sbiruduganti/IEEE-EOH-Acoustic-Array-Lung-Monitor/circuit-design/README.md

# circuit-design

Hardware design files for the 8-channel acoustic lung monitor ADC board.
