sbiruduganti/IEEE-EOH-Acoustic-Array-Lung-Monitor/adc_board-schematic.pdf

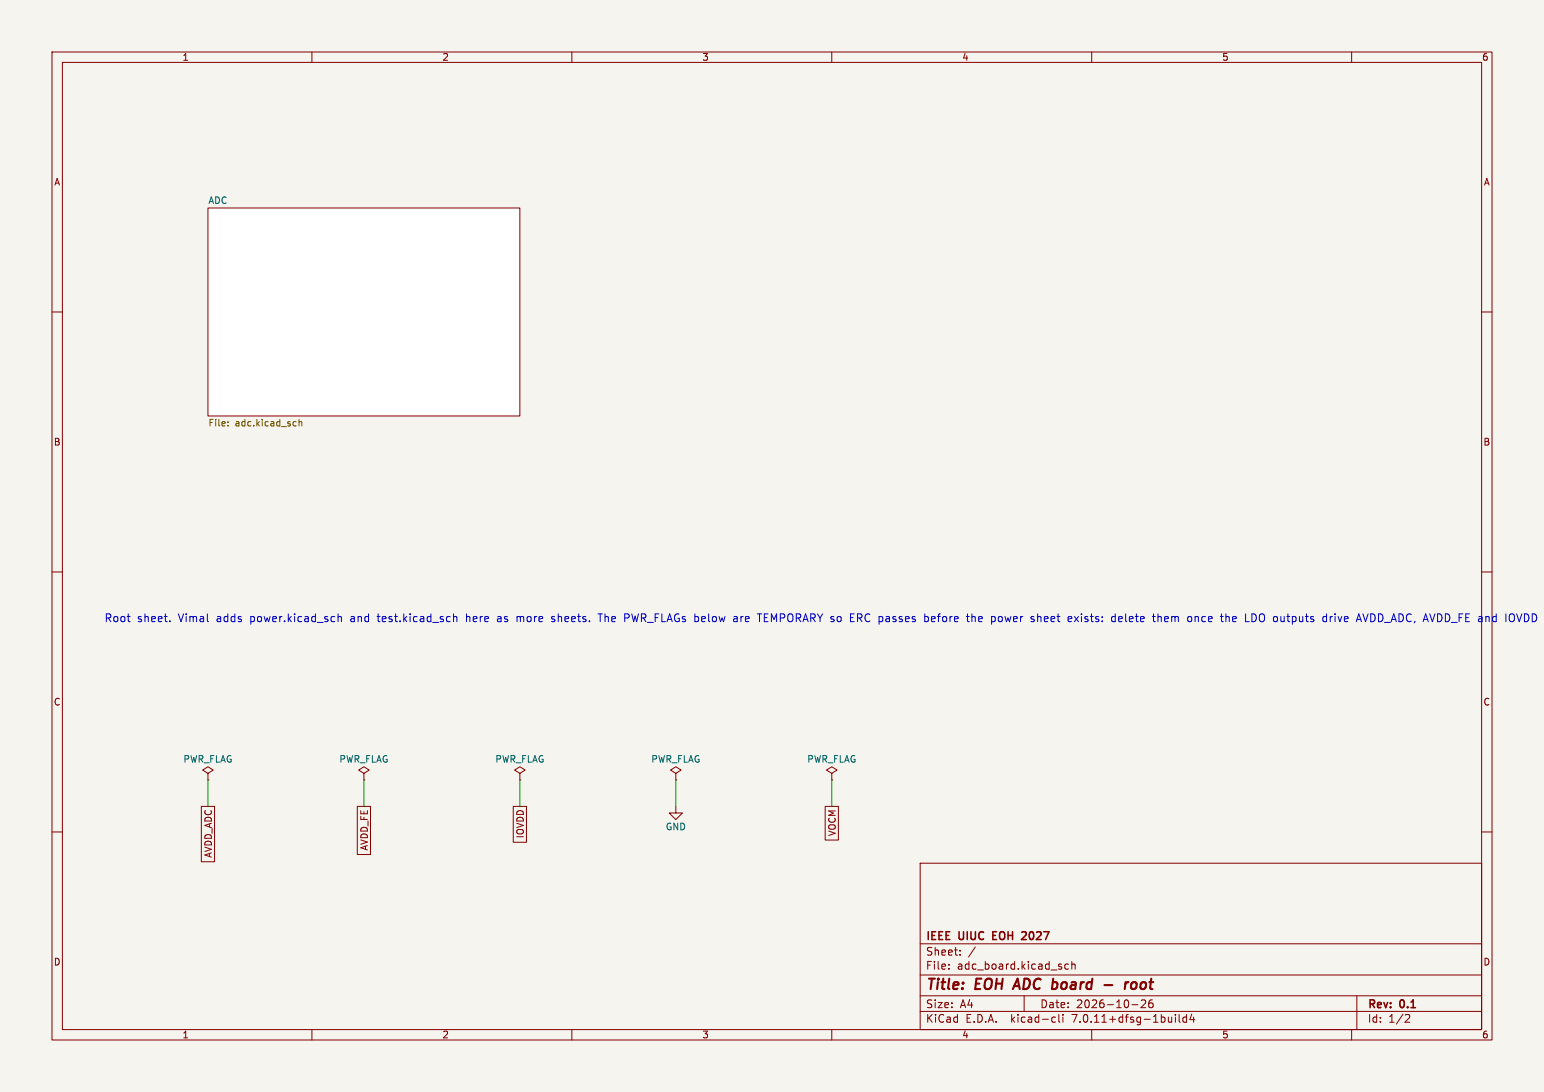
[picture p1: page 1]

Id: 1/2 Title: EOH ADC board - root File: adc_board.kicad_sch Sheet: /

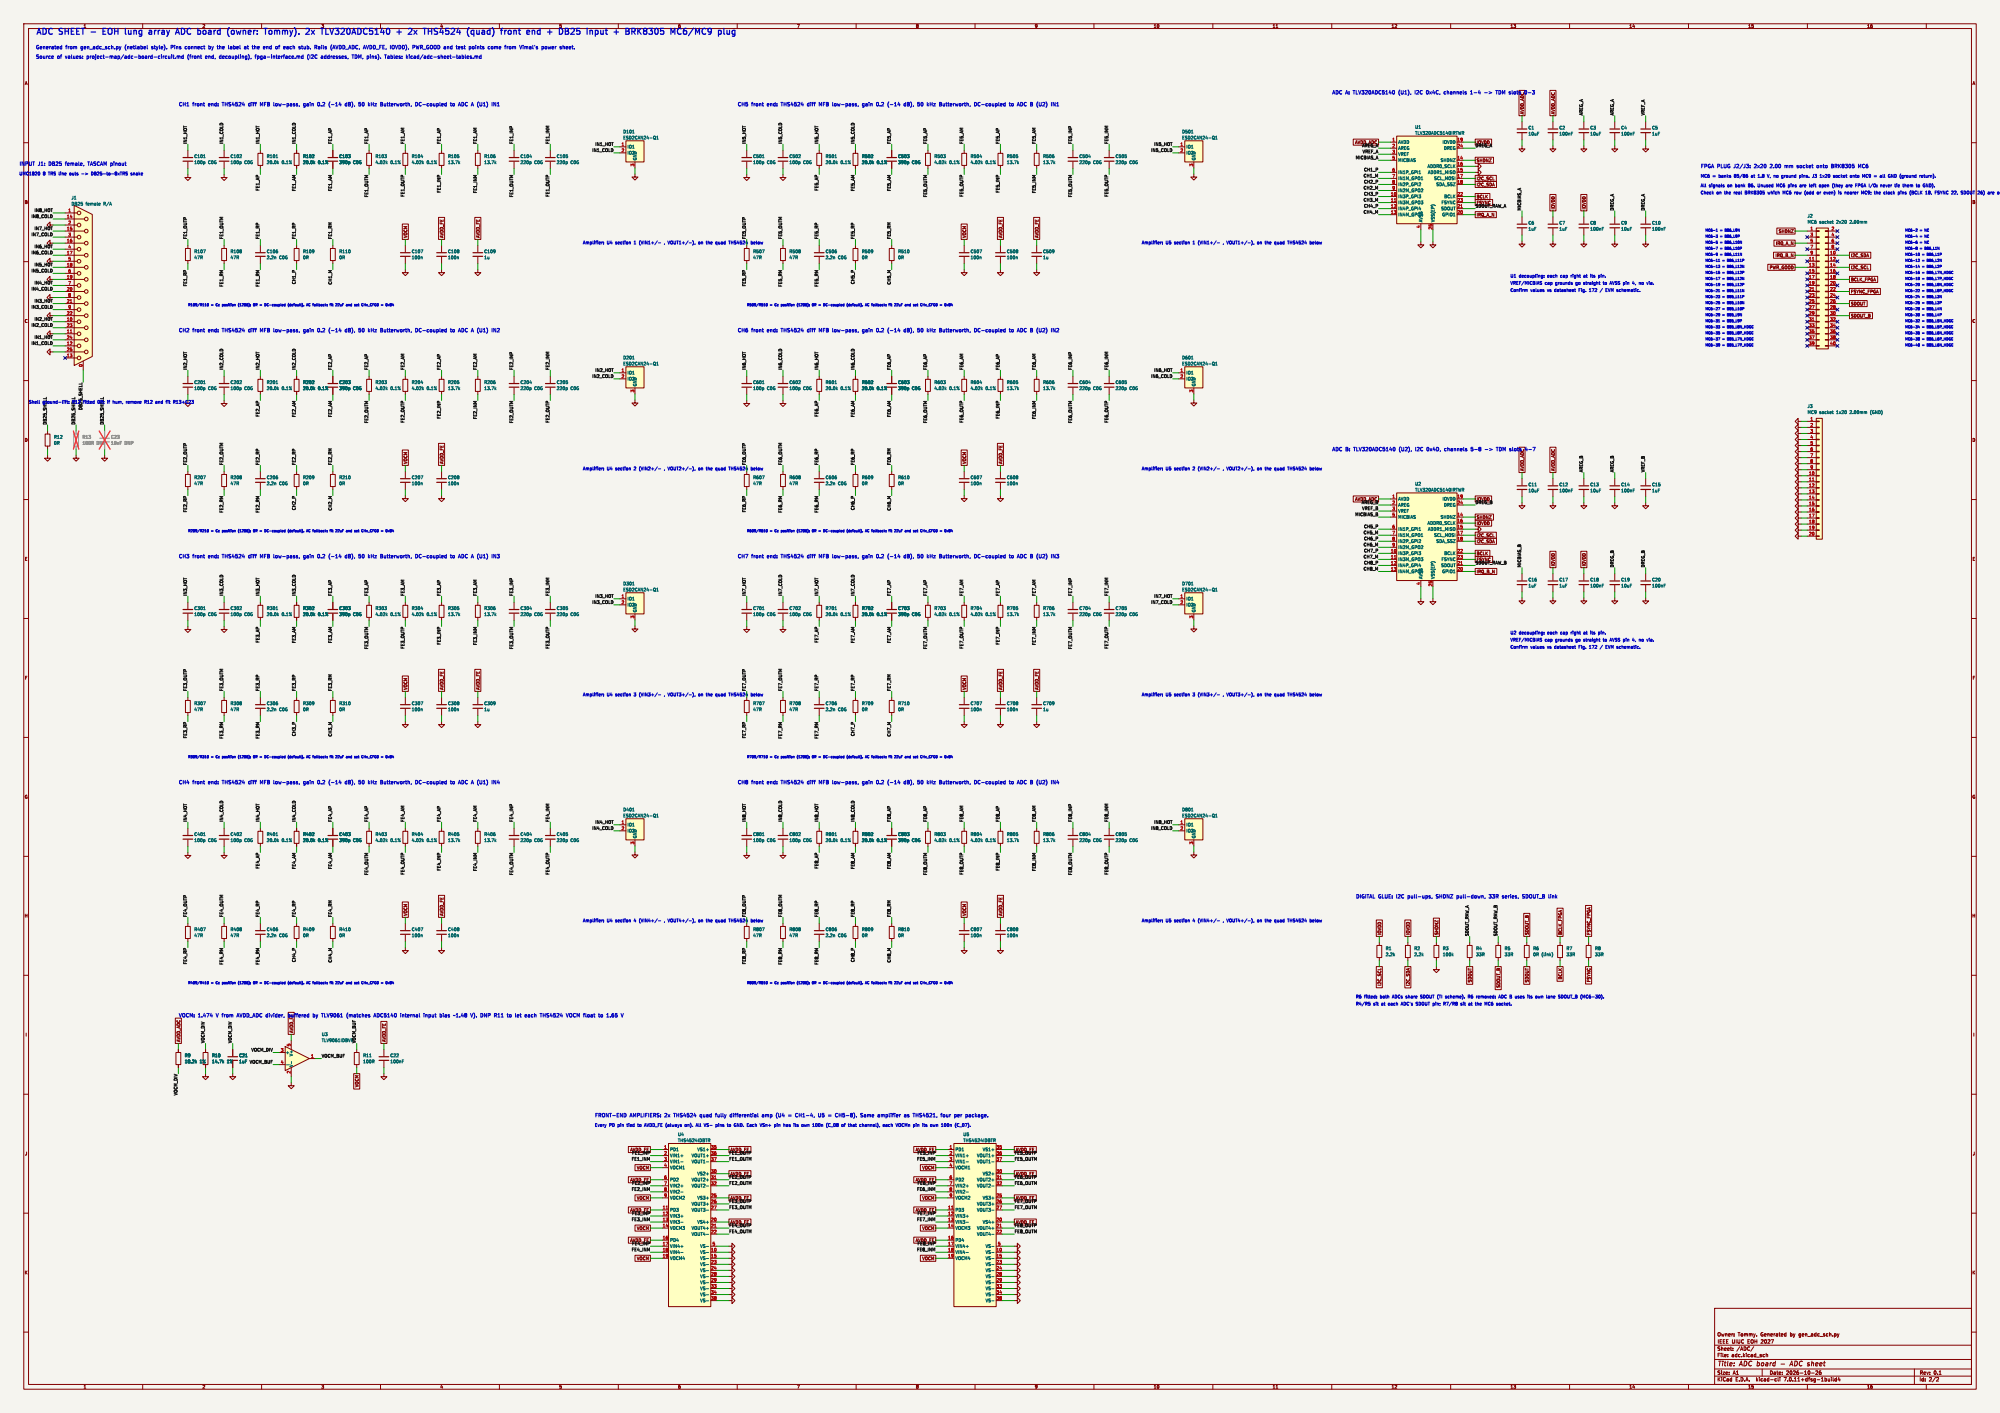
[picture p2: page 2]

R4/R5 sit at each ADC's SDOUT pin; R7/R8 sit at the MC6 socket.

VOCM: 1.474 V from AVDD_ADC divider, buffered by TLV9061 (matches ADC5140 internal input bias ~1.48 V). DNP R11 to let each THS4524 VOCM float to 1.65 V

Id: 2/2 Title: ADC board - ADC sheet File: adc.kicad_sch Sheet: /ADC/
