sbiruduganti/IEEE-EOH-Acoustic-Array-Lung-Monitor/circuit-design/IEEE Project/IEEE Project.kicad_sch

## KiCad design circuit-design/IEEE Project/IEEE Project.kicad_sch (2026-11-13)

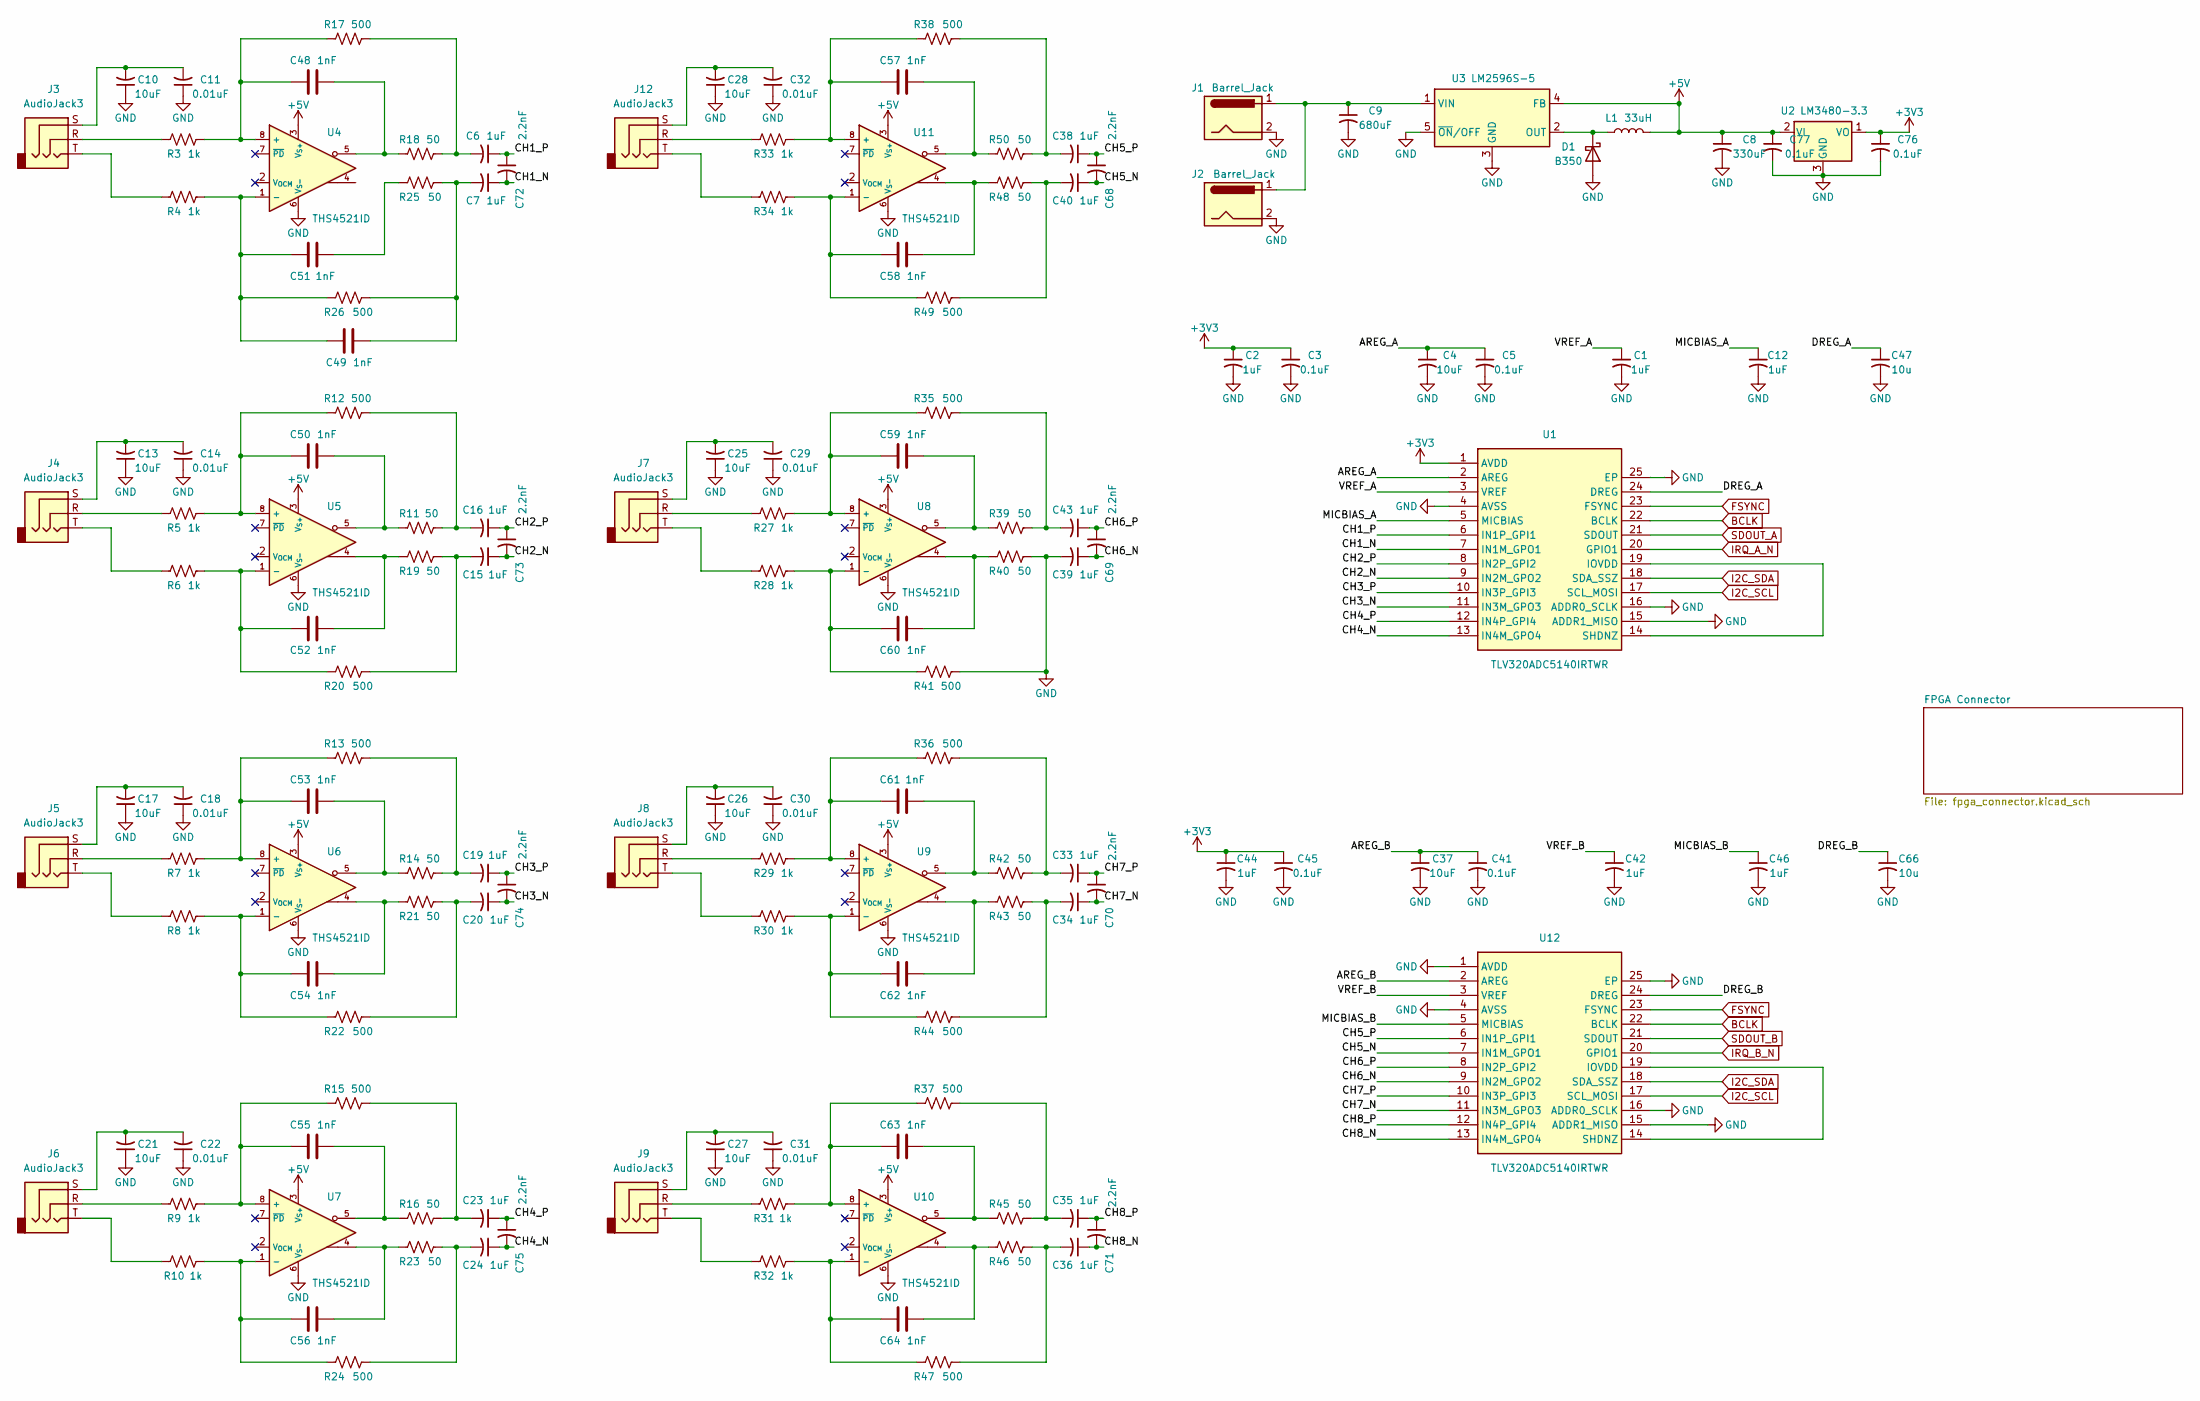
[picture p3: schematic IEEE Project.kicad_sch]

Parts:
C1, C2, C6, C7, C12, C15, C16, C19, C20, C23, C24, C33, C34, C35, C36, C38, C39, C40, C42, C43, C44, C46: 1uF
C3, C5, C41, C45, C76, C77: 0.1uF
C4, C10, C13, C17, C21, C25, C26, C27, C28, C37: 10uF
C8: 330uF
C9: 680uF
C11, C14, C18, C22, C29, C30, C31, C32: 0.01uF
C47, C66: 10u
C48, C49, C50, C51, C52, C53, C54, C55, C56, C57, C58, C59, C60, C61, C62, C63, C64: 1nF
C68, C69, C70, C71, C72, C73, C74, C75: 2.2nF
D1: B350; D_SMC
J1, J2: Barrel_Jack
J3, J4, J5, J6, J7, J8, J9, J12: AudioJack3
L1: 33uH
R3, R4, R5, R6, R7, R8, R9, R10, R27, R28, R29, R30, R31, R32, R33, R34: 1k
R11, R14, R16, R18, R19, R21, R23, R25, R39, R40, R42, R43, R45, R46, R48, R50: 50
R12, R13, R15, R17, R20, R22, R24, R26, R35, R36, R37, R38, R41, R44, R47, R49: 500
U1, U12: TLV320ADC5140IRTWR; QFN-24-1EP_4x4mm_P0.5mm_EP2.7x2.7mm; MPN TLV320ADC5140IRTWR; LCSC C2876368
U2: LM3480-3.3; SOT-23
U3: LM2596S-5; TO-263-5_TabPin3
U4, U5, U6, U7, U8, U9, U10, U11: THS4521ID; SOIC-8_3.9x4.9mm_P1.27mm

Connections:
+3V3: C2.1, C3.1, C44.1, C45.1, C76.1, U1.1 (AVDD), U2.1 (VO)
+5V: C8.1, C77.1, L1.2, U2.2 (VI), U3.4 (FB), U4.3 (V_{S+}), U5.3 (V_{S+}), U6.3 (V_{S+}), U7.3 (V_{S+}), U8.3 (V_{S+}), U9.3 (V_{S+}), U10.3 (V_{S+}), U11.3 (V_{S+})
AREG_A: C4.1, C5.1, U1.2 (AREG)
AREG_B: C37.1, C41.1, U12.2 (AREG)
BCLK: U1.22 (BCLK), U12.22 (BCLK)
CH1_N: C7.1, C72.2, U1.7 (IN1M_GPO1)
CH1_P: C6.1, C72.1, U1.6 (IN1P_GPI1)
CH2_N: C15.1, C73.2, U1.9 (IN2M_GPO2)
CH2_P: C16.1, C73.1, U1.8 (IN2P_GPI2)
CH3_N: C20.1, C74.2, U1.11 (IN3M_GPO3)
CH3_P: C19.1, C74.1, U1.10 (IN3P_GPI3)
CH4_N: C24.1, C75.2, U1.13 (IN4M_GPO4)
CH4_P: C23.1, C75.1, U1.12 (IN4P_GPI4)
CH5_N: C40.1, C68.2, U12.7 (IN1M_GPO1)
CH5_P: C38.1, C68.1, U12.6 (IN1P_GPI1)
CH6_N: C39.1, C69.2, U12.9 (IN2M_GPO2)
CH6_P: C43.1, C69.1, U12.8 (IN2P_GPI2)
CH7_N: C34.1, C70.2, U12.11 (IN3M_GPO3)
CH7_P: C33.1, C70.1, U12.10 (IN3P_GPI3)
CH8_N: C36.1, C71.2, U12.13 (IN4M_GPO4)
CH8_P: C35.1, C71.1, U12.12 (IN4P_GPI4)
DREG_A: C47.1, U1.24 (DREG)
DREG_B: C66.1, U12.24 (DREG)
FSYNC: U1.23 (FSYNC), U12.23 (FSYNC)
GND: C1.2, C2.2, C3.2, C4.2, C5.2, C8.2, C9.2, C10.1, C11.1, C12.2, C13.1, C14.1, C17.1, C18.1, C21.1, C22.1, C25.1, C26.1, C27.1, C28.1, C29.1, C30.1, C31.1, C32.1, C37.2, C39.2, C41.2, C42.2, C44.2, C45.2, C46.2, C47.2, C66.2, C76.2, C77.2, D1.2 (A), J1.2, J2.2, R40.2, R41.2, U1.4 (AVSS), U1.15 (ADDR1_MISO), U1.16 (ADDR0_SCLK), U1.25 (EP), U2.3 (GND), U3.3 (GND), U3.5 (~ON/OFF), U4.6 (V_{S-}), U5.6 (V_{S-}), U6.6 (V_{S-}), U7.6 (V_{S-}), U8.6 (V_{S-}), U9.6 (V_{S-}), U10.6 (V_{S-}), U11.6 (V_{S-}), U12.1 (AVDD), U12.4 (AVSS), U12.15 (ADDR1_MISO), U12.16 (ADDR0_SCLK), U12.25 (EP)
I2C_SCL: U1.17 (SCL_MOSI), U12.17 (SCL_MOSI)
I2C_SDA: U1.18 (SDA_SSZ), U12.18 (SDA_SSZ)
IRQ_A_N: U1.20 (GPIO1)
IRQ_B_N: U12.20 (GPIO1)
MICBIAS_A: C12.1, U1.5 (MICBIAS)
MICBIAS_B: C46.1, U12.5 (MICBIAS)
unnamed: C6.2, R17.2, R18.2
unnamed: C9.1, J1.1, J2.1, U3.1 (VIN)
unnamed: C10.2, C11.2, J3.S
unnamed: C13.2, C14.2, J4.S
unnamed: C15.2, R19.2, R20.2
unnamed: C16.2, R11.2, R12.2
unnamed: C17.2, C18.2, J5.S
unnamed: C19.2, R13.2, R14.2
unnamed: C20.2, R21.2, R22.2
unnamed: C21.2, C22.2, J6.S
unnamed: C23.2, R15.2, R16.2
unnamed: C24.2, R23.2, R24.2
unnamed: C25.2, C29.2, J7.S
unnamed: C26.2, C30.2, J8.S
unnamed: C27.2, C31.2, J9.S
unnamed: C28.2, C32.2, J12.S
unnamed: C33.2, R36.2, R42.2
unnamed: C34.2, R43.2, R44.2
unnamed: C35.2, R37.2, R45.2
unnamed: C36.2, R46.2, R47.2
unnamed: C38.2, R38.2, R50.2
unnamed: C40.2, R48.2, R49.2
unnamed: C43.2, R35.2, R39.2
unnamed: C48.1, R3.2, R17.1, U4.8 (+)
unnamed: C48.2, R18.1, U4.5
unnamed: C49.1, C51.1, R4.2, R26.1, U4.1 (-)
unnamed: C7.2, C49.2, R25.2, R26.2
unnamed: C50.1, R5.2, R12.1, U5.8 (+)
unnamed: C50.2, R11.1, U5.5
unnamed: C51.2, R25.1
unnamed: C52.1, R6.2, R20.1, U5.1 (-)
unnamed: C52.2, R19.1, U5.4
unnamed: C53.1, R7.2, R13.1, U6.8 (+)
unnamed: C53.2, R14.1, U6.5
unnamed: C54.1, R8.2, R22.1, U6.1 (-)
unnamed: C54.2, R21.1, U6.4
unnamed: C55.1, R9.2, R15.1, U7.8 (+)
unnamed: C55.2, R16.1, U7.5
unnamed: C56.1, R10.2, R24.1, U7.1 (-)
unnamed: C56.2, R23.1, U7.4
unnamed: C57.1, R33.2, R38.1, U11.8 (+)
unnamed: C57.2, R50.1, U11.5
unnamed: C58.1, R34.2, R49.1, U11.1 (-)
unnamed: C58.2, R48.1, U11.4
unnamed: C59.1, R27.2, R35.1, U8.8 (+)
unnamed: C59.2, R39.1, U8.5
unnamed: C60.1, R28.2, R41.1, U8.1 (-)
unnamed: C60.2, R40.1, U8.4
unnamed: C61.1, R29.2, R36.1, U9.8 (+)
unnamed: C61.2, R42.1, U9.5
unnamed: C62.1, R30.2, R44.1, U9.1 (-)
unnamed: C62.2, R43.1, U9.4
unnamed: C63.1, R31.2, R37.1, U10.8 (+)
unnamed: C63.2, R45.1, U10.5
unnamed: C64.1, R32.2, R47.1, U10.1 (-)
unnamed: C64.2, R46.1, U10.4
unnamed: D1.1 (K), L1.1, U3.2 (OUT)
unnamed: J3.R, R3.1
unnamed: J3.T, R4.1
unnamed: J4.R, R5.1
unnamed: J4.T, R6.1
unnamed: J5.R, R7.1
unnamed: J5.T, R8.1
unnamed: J6.R, R9.1
unnamed: J6.T, R10.1
unnamed: J7.R, R27.1
unnamed: J7.T, R28.1
unnamed: J8.R, R29.1
unnamed: J8.T, R30.1
unnamed: J9.R, R31.1
unnamed: J9.T, R32.1
unnamed: J12.R, R33.1
unnamed: J12.T, R34.1
unnamed: U1.14 (SHDNZ), U1.19 (IOVDD)
unnamed: U12.14 (SHDNZ), U12.19 (IOVDD)
SDOUT_A: U1.21 (SDOUT)
SDOUT_B: U12.21 (SDOUT)
VREF_A: C1.1, U1.3 (VREF)
VREF_B: C42.1, U12.3 (VREF)
