sbiruduganti/IEEE-EOH-Acoustic-Array-Lung-Monitor/circuit-design/IEEE Project/IEEE Project_withconnector.kicad_sch

## KiCad design circuit-design/IEEE Project/IEEE Project_withconnector.kicad_sch (2026-11-07)

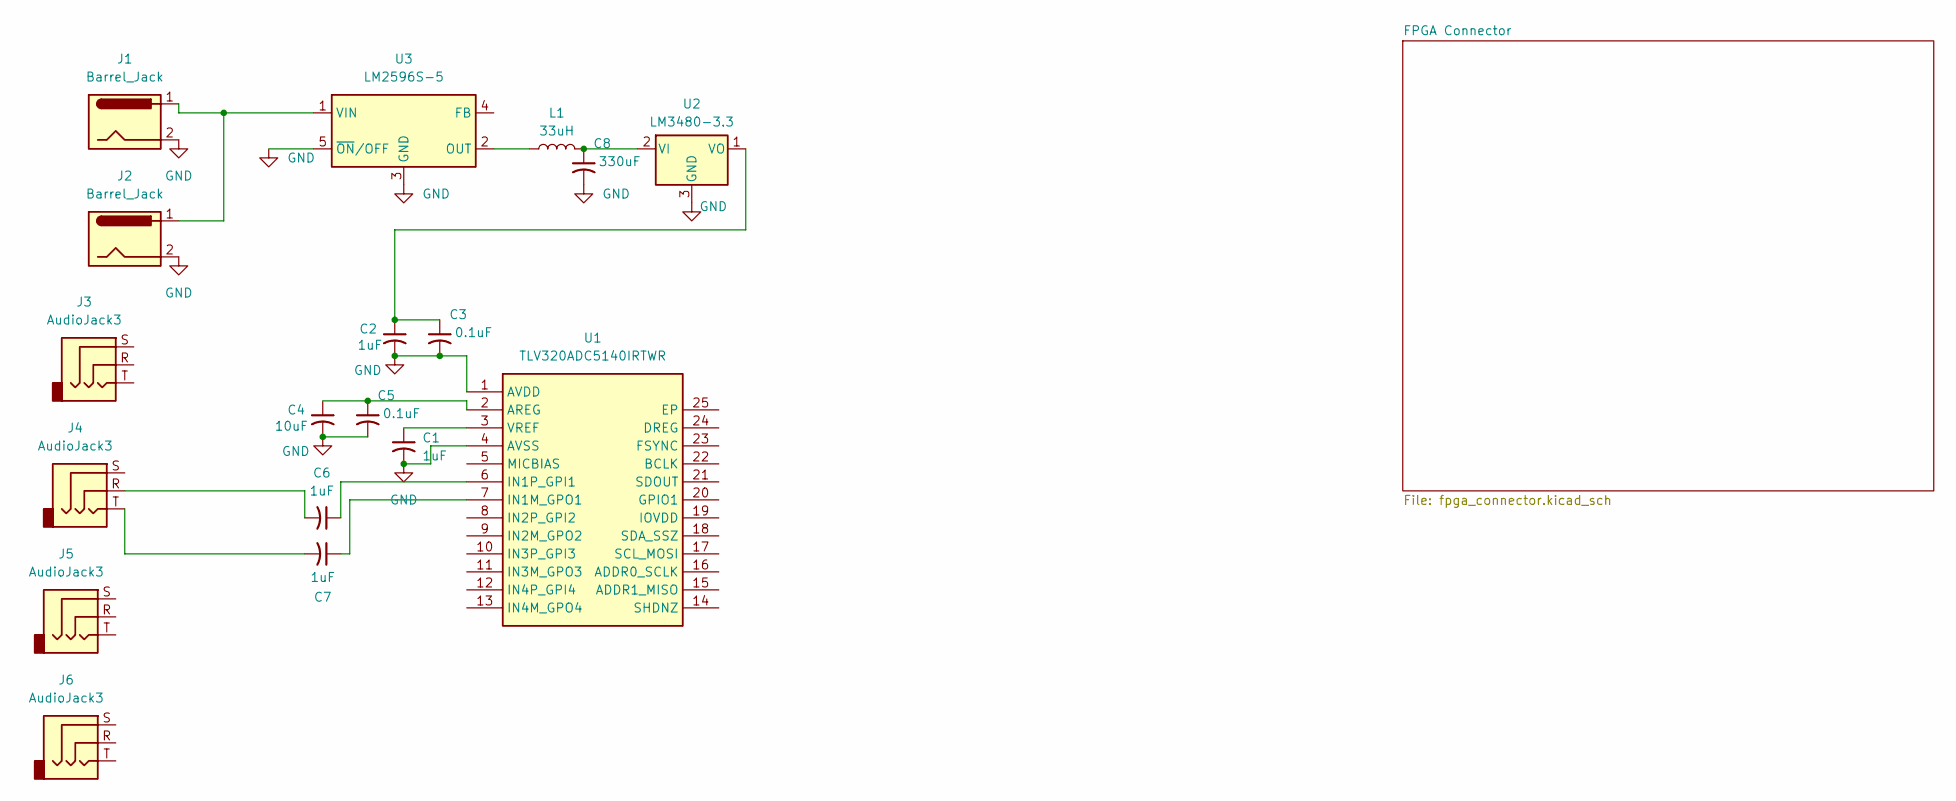
[picture p5: schematic IEEE Project_withconnector.kicad_sch]

Parts:
C1, C2, C6, C7: 1uF
C3, C5: 0.1uF
C4: 10uF
C8: 330uF
J1, J2: Barrel_Jack
J3, J4, J5, J6: AudioJack3
L1: 33uH
U1: TLV320ADC5140IRTWR; QFN-24-1EP_4x4mm_P0.5mm_EP2.7x2.7mm; MPN TLV320ADC5140IRTWR; LCSC C2876368
U2: LM3480-3.3; SOT-23
U3: LM2596S-5; TO-263-5_TabPin3

Connections:
GND: C1.2, C2.2, C3.2, C4.2, C5.2, C8.2, J1.2, J2.2, U1.1 (AVDD), U1.4 (AVSS), U2.3 (GND), U3.3 (GND), U3.5 (~ON/OFF)
unnamed: C1.1, U1.3 (VREF)
unnamed: C2.1, C3.1, U2.1 (VO)
unnamed: C4.1, C5.1, U1.2 (AREG)
unnamed: C6.1, U1.6 (IN1P_GPI1)
unnamed: C6.2, J4.R
unnamed: C7.1, U1.7 (IN1M_GPO1)
unnamed: C7.2, J4.T
unnamed: C8.1, L1.2, U2.2 (VI)
unnamed: J1.1, J2.1, U3.1 (VIN)
unnamed: L1.1, U3.2 (OUT)
