sbiruduganti/IEEE-EOH-Acoustic-Array-Lung-Monitor/circuit-design/IEEE Project/fpga_connector.kicad_sch

## KiCad design circuit-design/IEEE Project/fpga_connector.kicad_sch (2026-11-13)

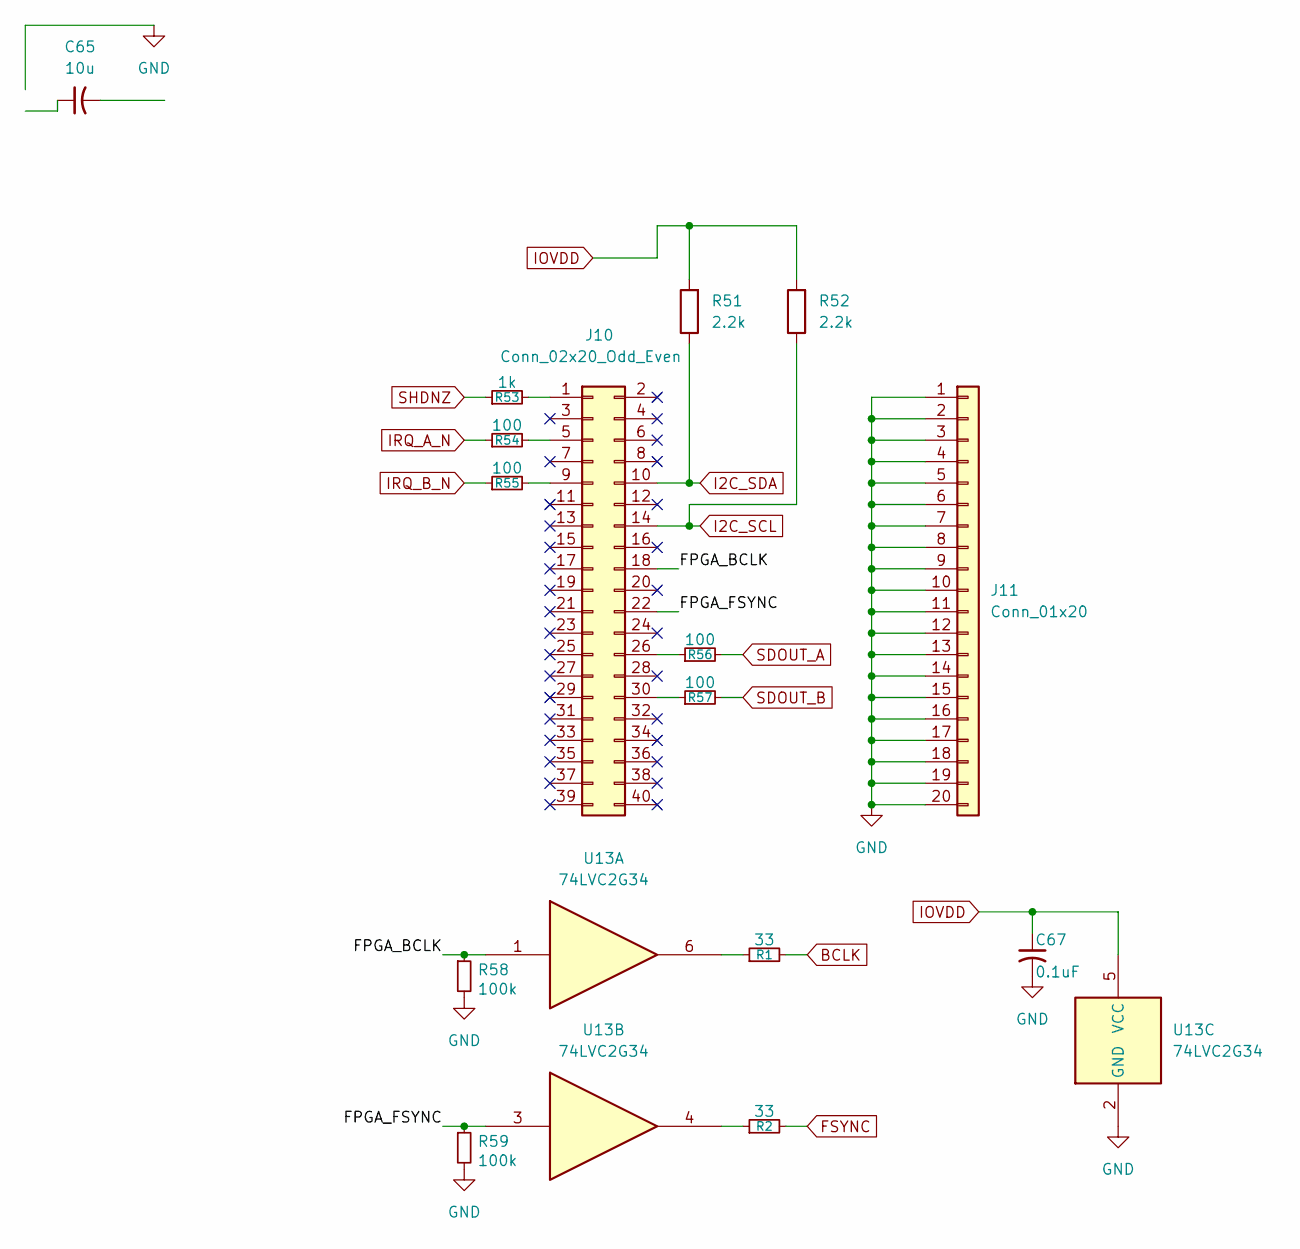
[picture p6: schematic fpga_connector.kicad_sch]

Parts:
C65: 10u
C67: 0.1uF; C_0805_2012Metric
J10: Conn_02x20_Odd_Even; PinSocket_2x20_P2.00mm_Vertical
J11: Conn_01x20; PinSocket_1x20_P2.00mm_Vertical
R1, R2: 33; R_0603_1608Metric
R51, R52: 2.2k; R_0805_2012Metric
R53: 1k; R_0805_2012Metric
R54, R55, R56, R57: 100; R_0805_2012Metric
R58, R59: 100k; R_0805_2012Metric
U13: 74LVC2G34; SOT-23-6

Connections:
BCLK: R1.2
FPGA_BCLK: J10.18, R58.1, U13.1
FPGA_FSYNC: J10.22, R59.1, U13.3
FSYNC: R2.2
GND: C67.2, J11.1, J11.2, J11.3, J11.4, J11.5, J11.6, J11.7, J11.8, J11.9, J11.10, J11.11, J11.12, J11.13, J11.14, J11.15, J11.16, J11.17, J11.18, J11.19, J11.20, R58.2, R59.2, U13.2 (GND)
I2C_SCL: J10.14, R52.1
I2C_SDA: J10.10, R51.1
IOVDD: C67.1, R51.2, R52.2, U13.5 (VCC)
IRQ_A_N: R54.1
IRQ_B_N: R55.1
unnamed: J10.1, R53.2
unnamed: J10.5, R54.2
unnamed: J10.9, R55.2
unnamed: J10.26, R56.1
unnamed: J10.30, R57.1
unnamed: R1.1, U13.6
unnamed: R2.1, U13.4
SDOUT_A: R56.2
SDOUT_B: R57.2
SHDNZ: R53.1
