sbiruduganti/IEEE-EOH-Acoustic-Array-Lung-Monitor/circuit-design/KiCAD files/adc.kicad_sch

## KiCad design circuit-design/KiCAD files/adc.kicad_sch (2026-10-28)

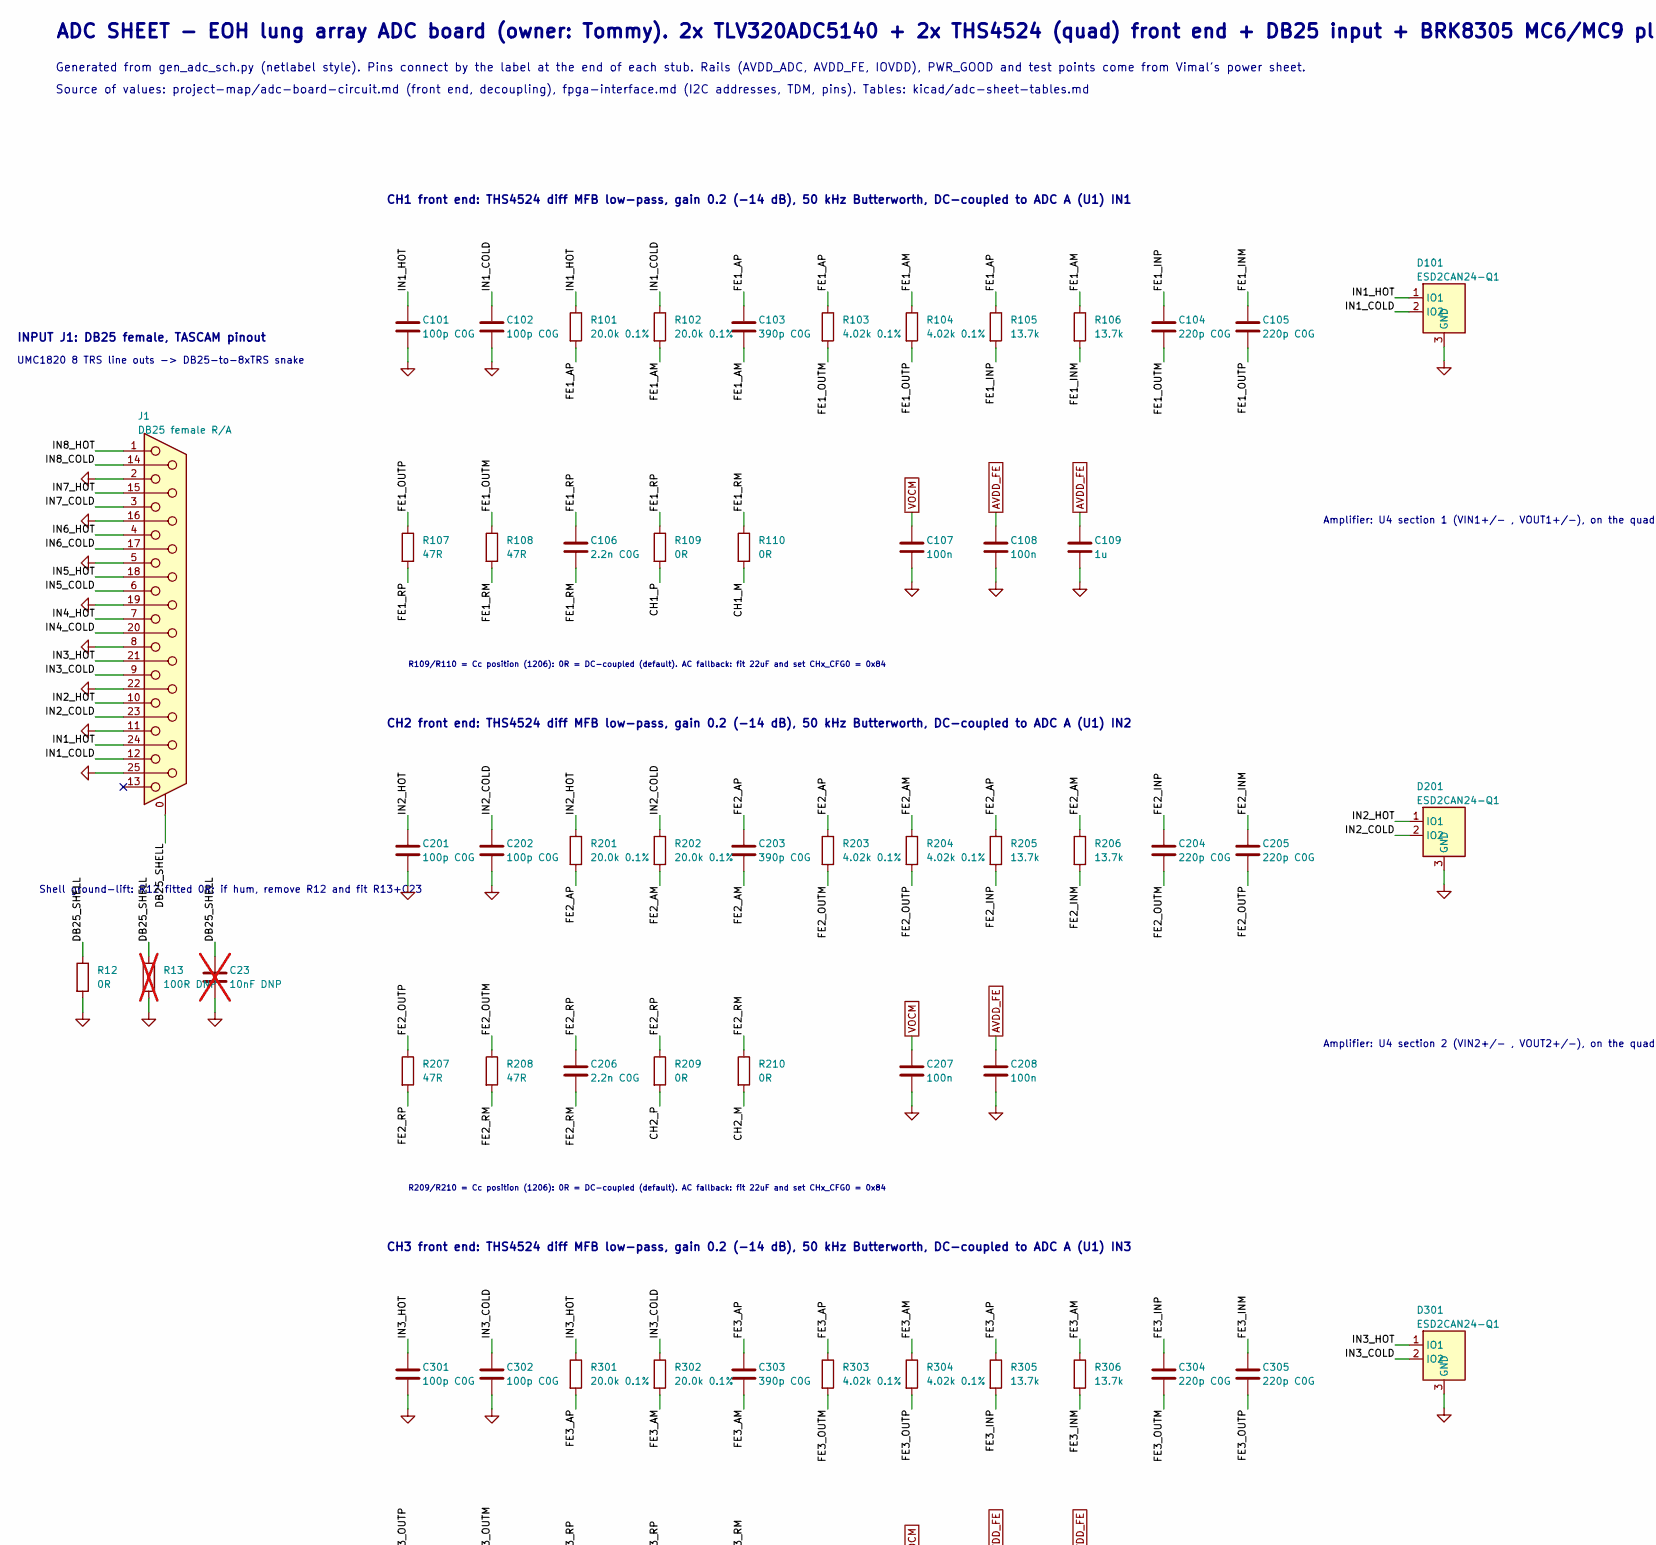
[picture p7: schematic adc.kicad_sch, part in row 1, column 1]

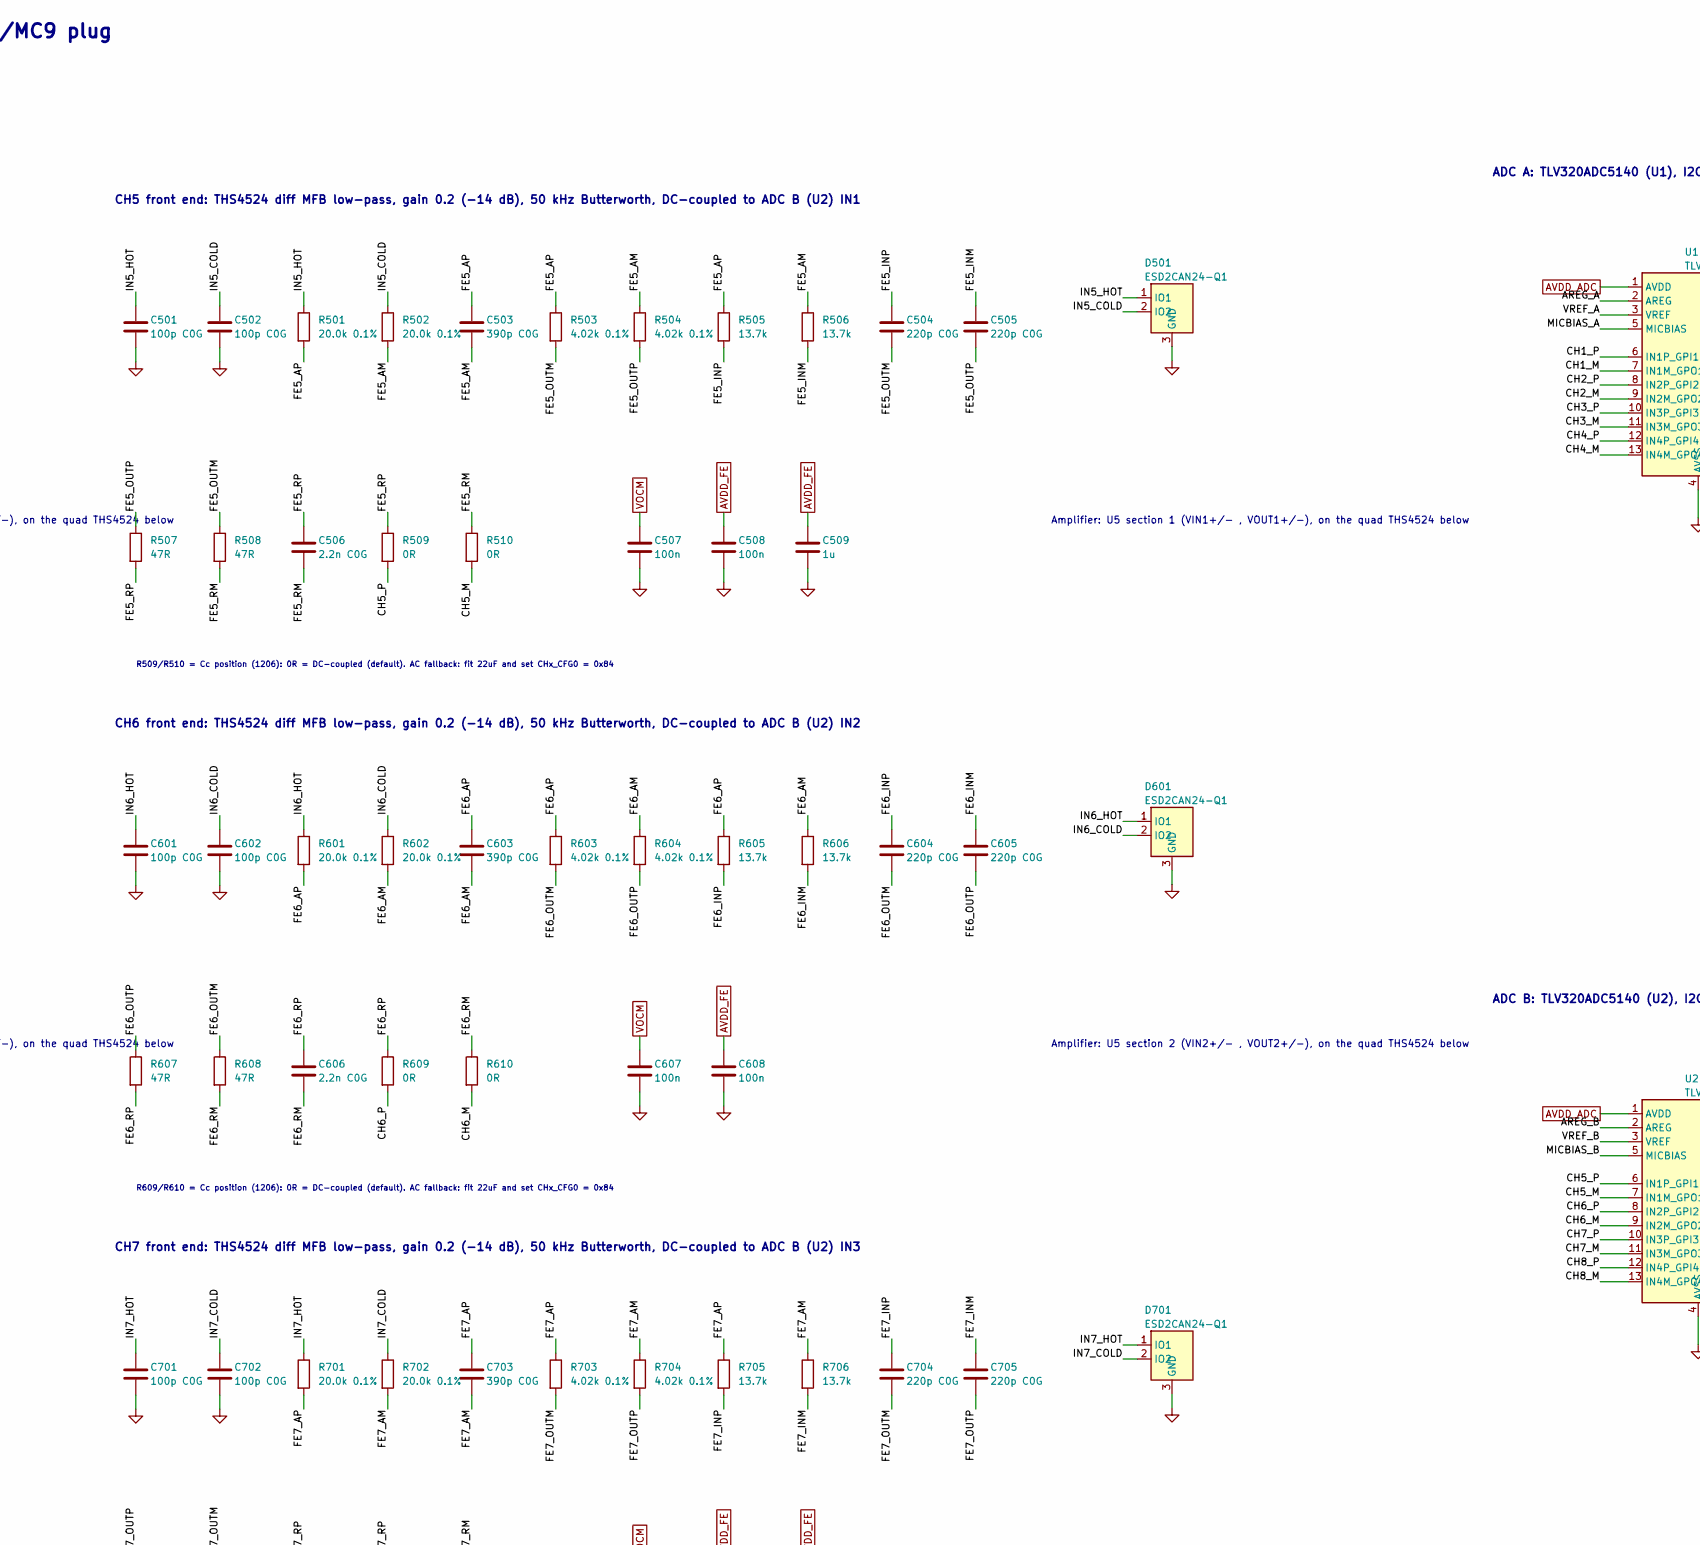
[picture p8: schematic adc.kicad_sch, part in row 1, column 2]

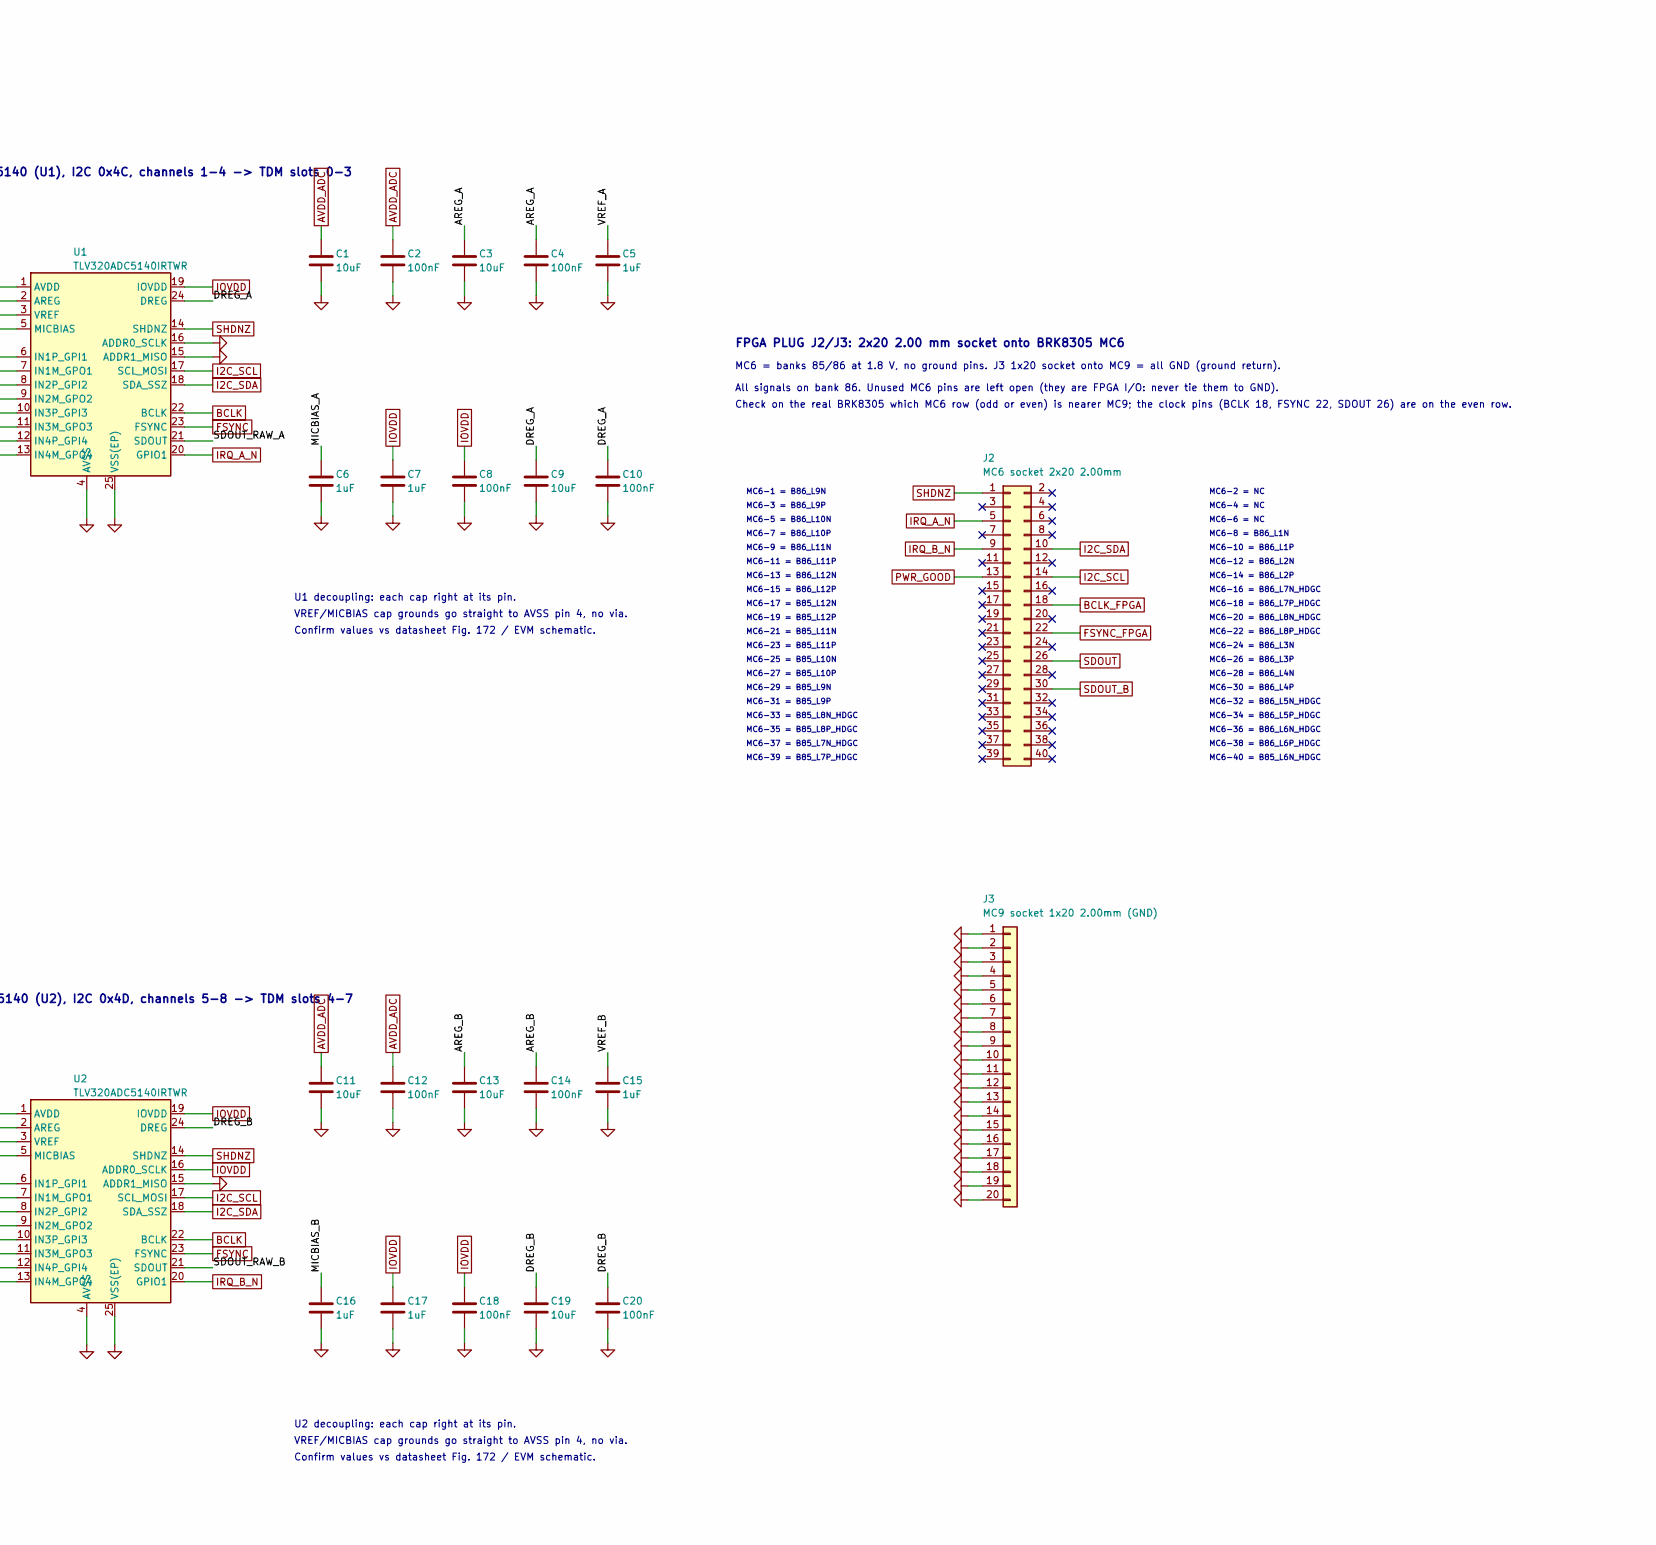
[picture p9: schematic adc.kicad_sch, part in row 1, column 3]

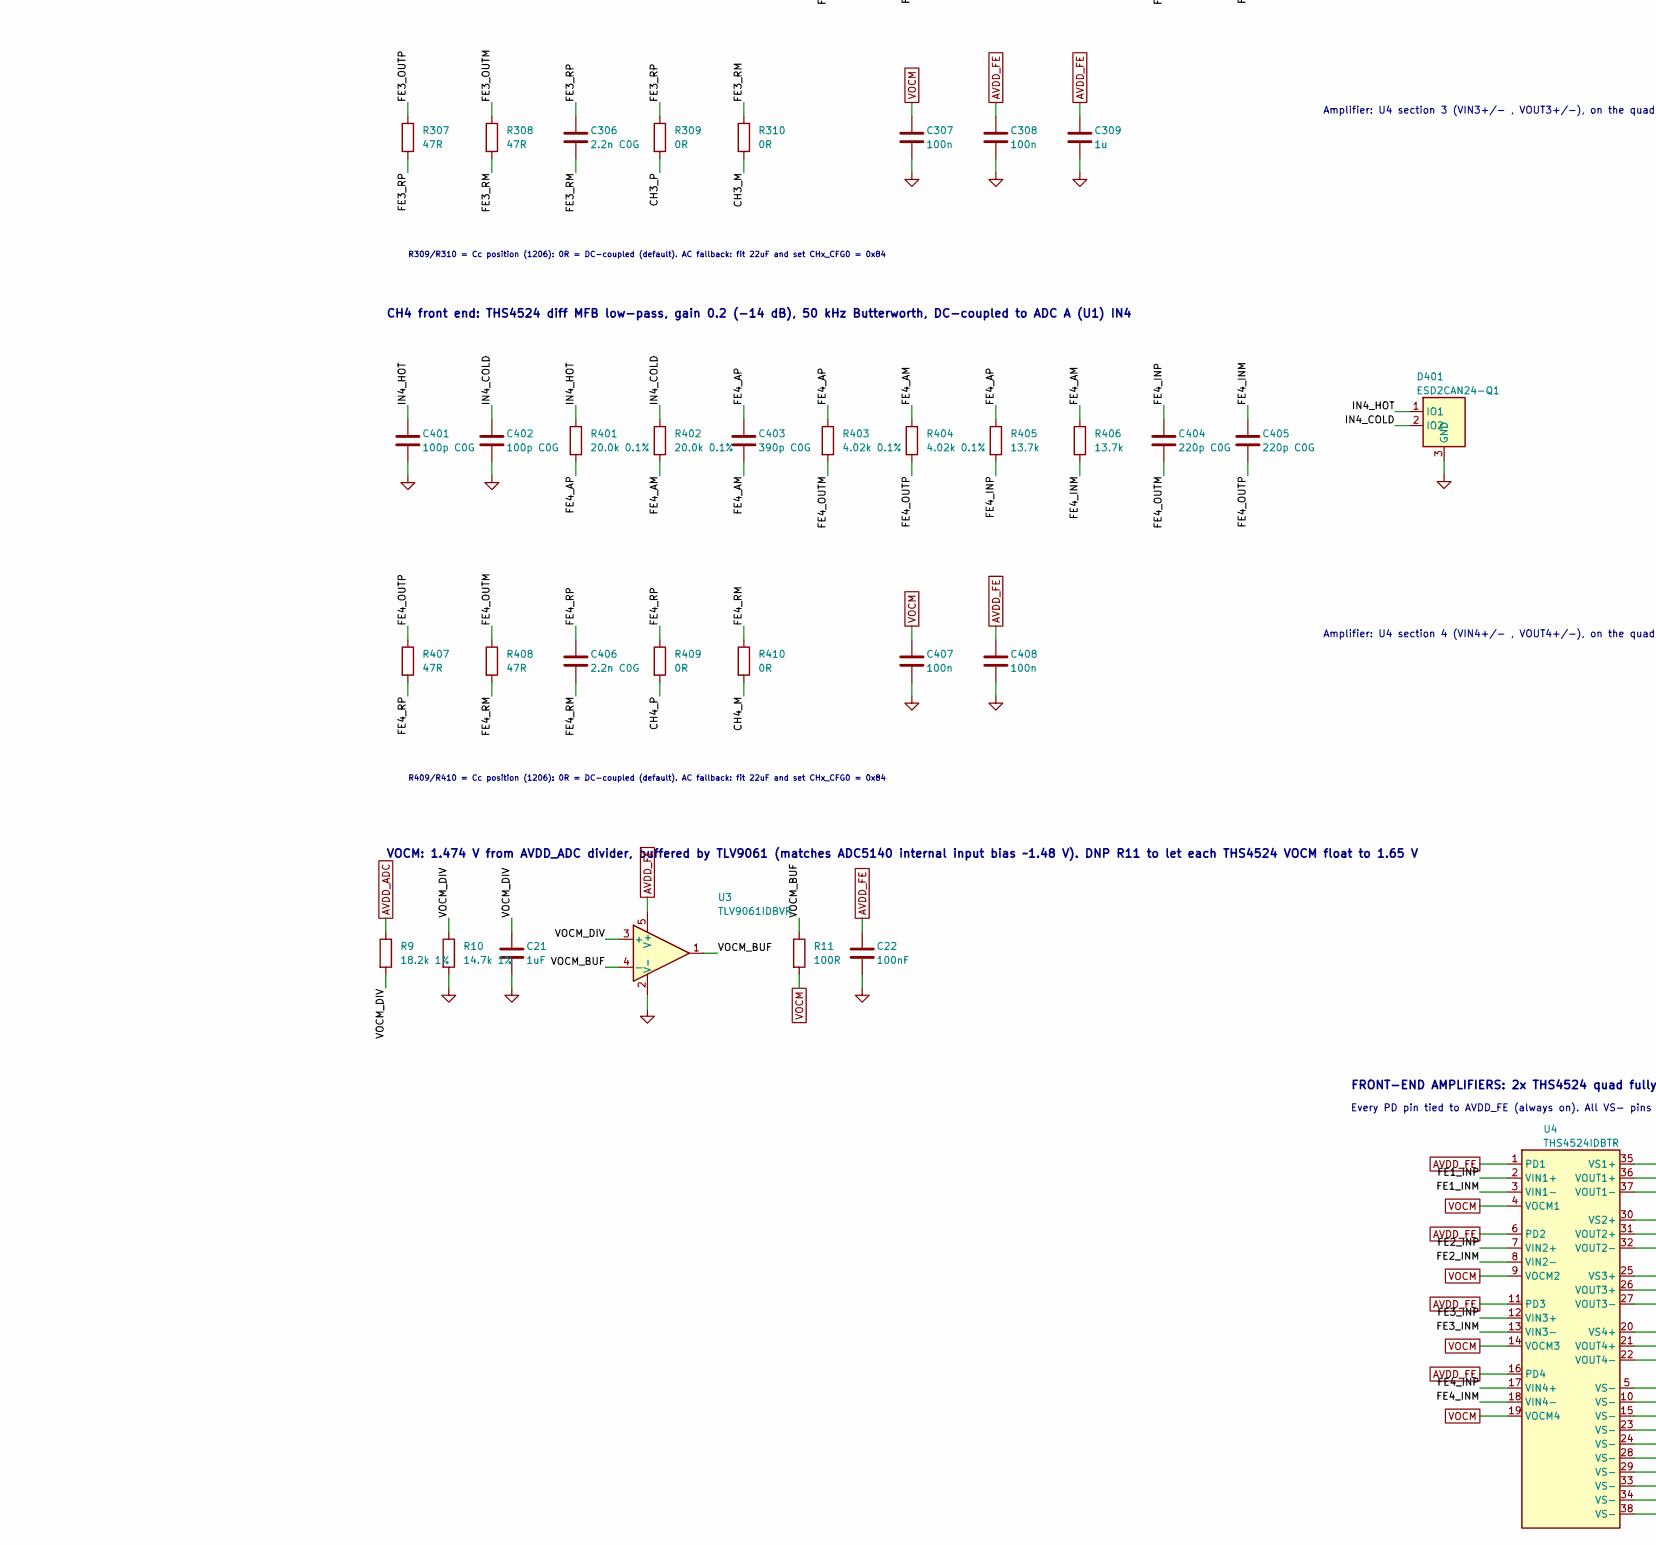
[picture p10: schematic adc.kicad_sch, part in row 2, column 1]

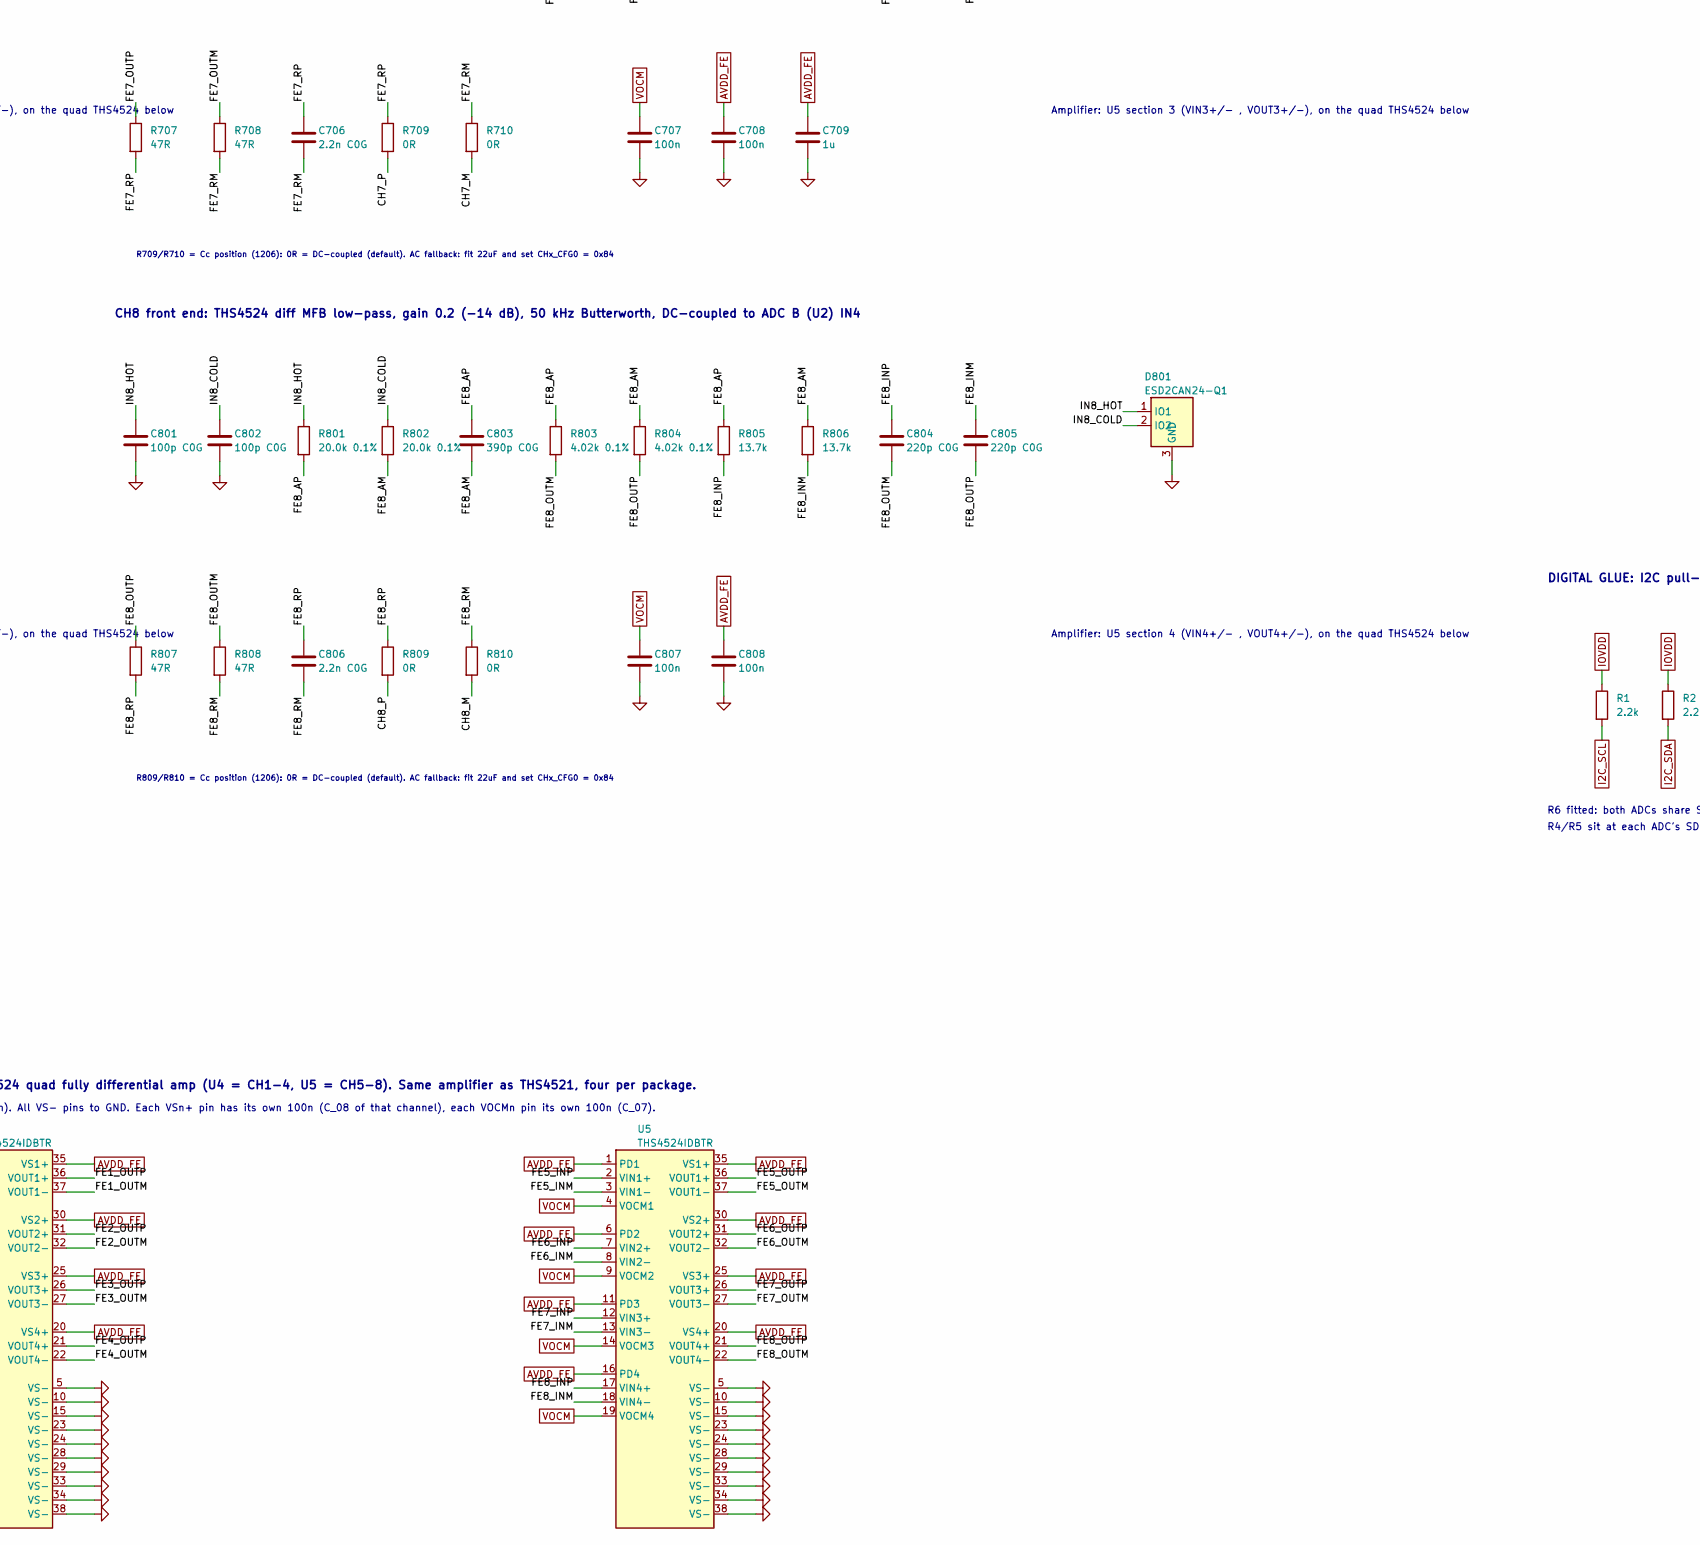
[picture p11: schematic adc.kicad_sch, part in row 2, column 2]

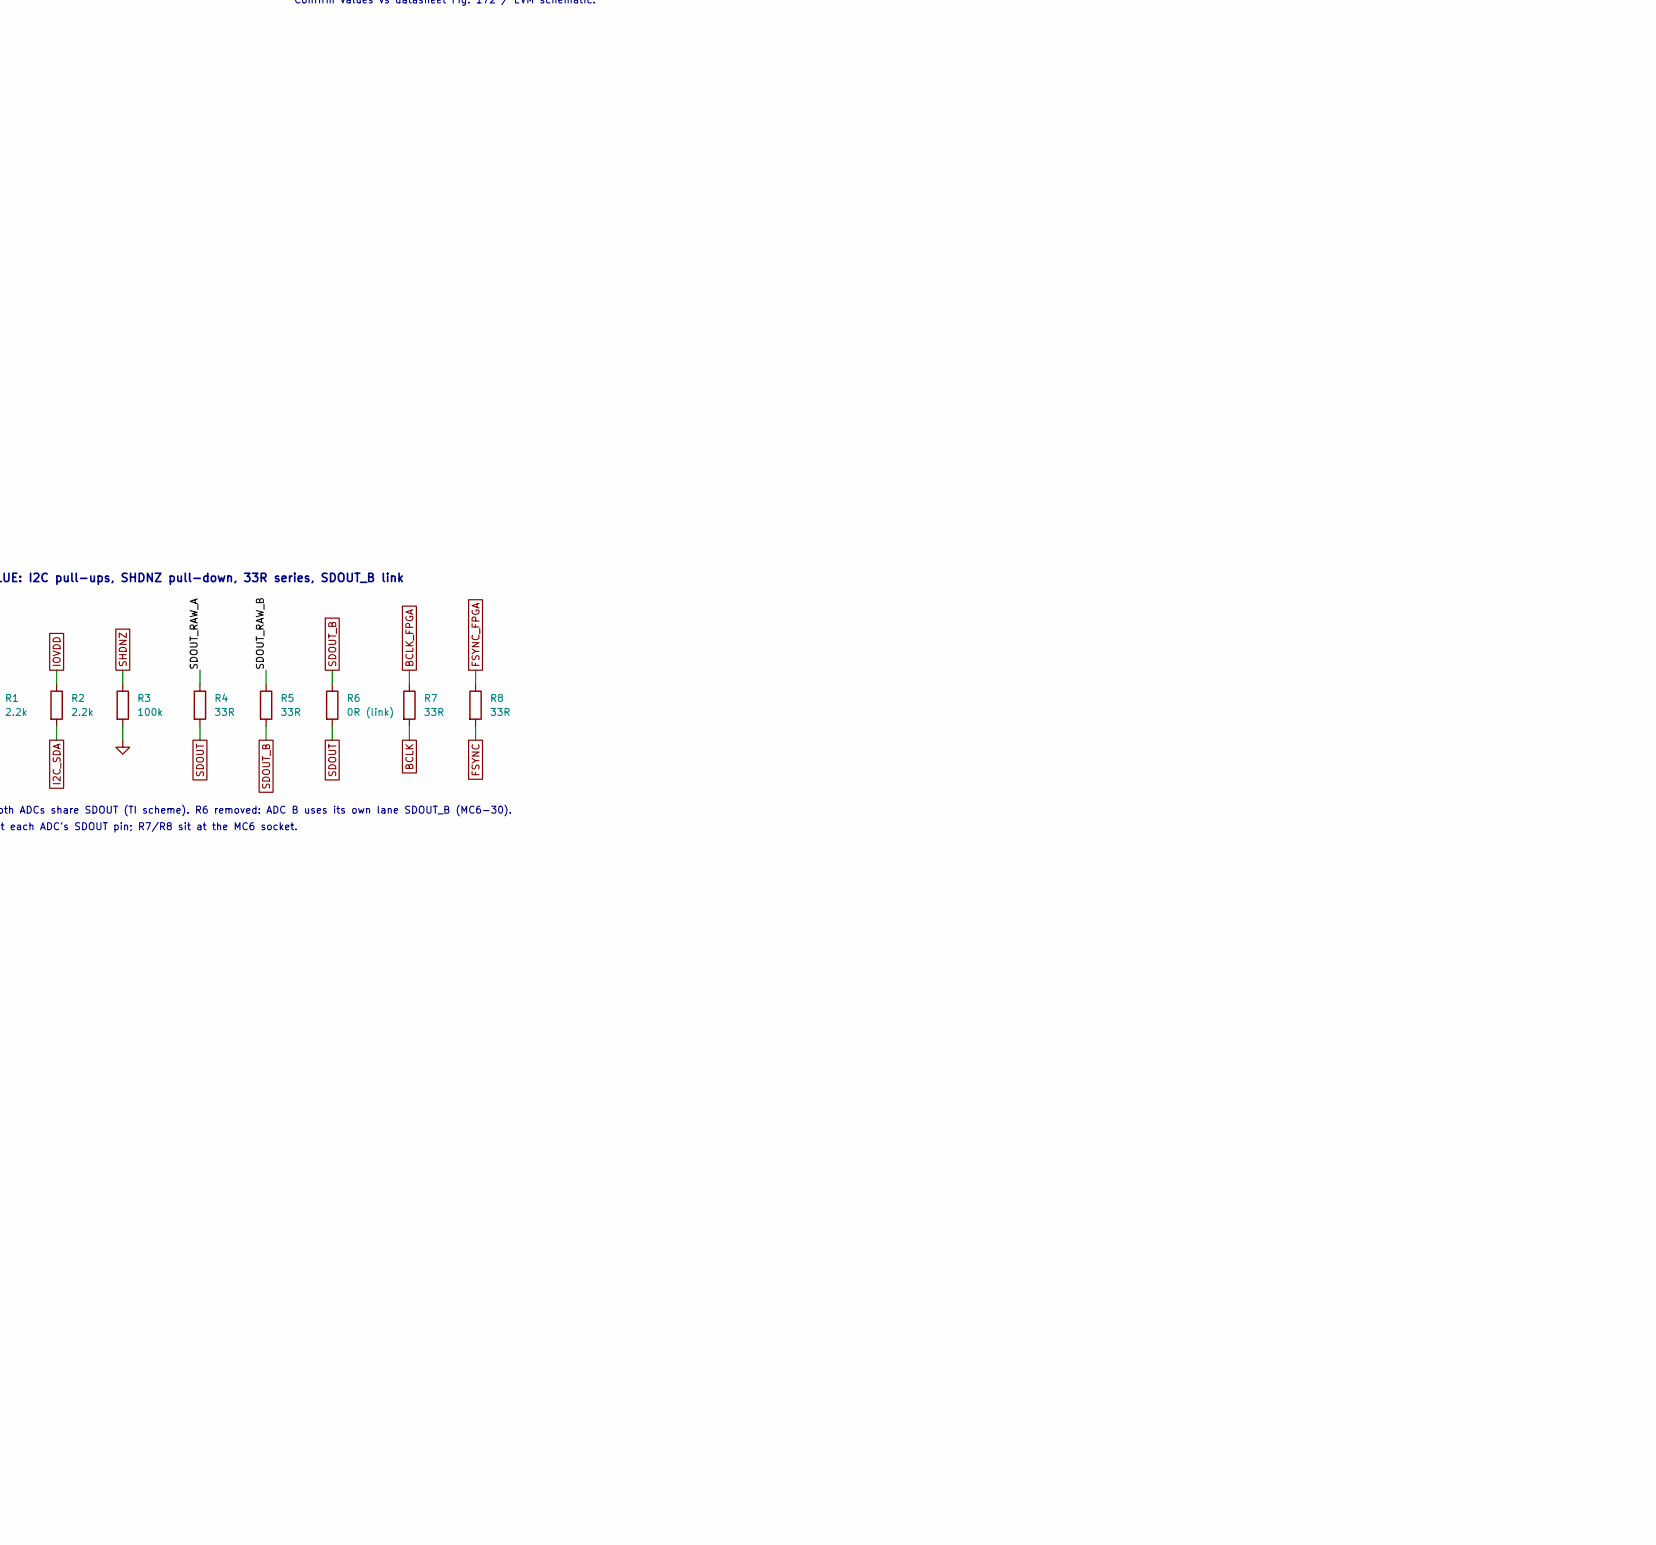
[picture p12: schematic adc.kicad_sch, part in row 2, column 3]

Parts:
C1, C3, C9, C11, C13, C19: 10uF; C_0805_2012Metric; MPN Samsung CL21B106KOQNNNE
C2, C4, C8, C10, C12, C14, C18, C20, C22: 100nF; C_0603_1608Metric; MPN KEMET C0603C104K5RACTU
C5, C6, C7, C15, C16, C17, C21: 1uF; C_0603_1608Metric; MPN KEMET C0603C105K4RACTU
C23: 10nF DNP; C_0603_1608Metric; not fitted
C101, C102, C201, C202, C301, C302, C401, C402, C501, C502, C601, C602, C701, C702, C801, C802: 100p C0G; C_0603_1608Metric; MPN Murata GRM1885C1H101JA01D
C103, C203, C303, C403, C503, C603, C703, C803: 390p C0G; C_0603_1608Metric; MPN Murata GRM1885C1H391GA01D
C104, C105, C204, C205, C304, C305, C404, C405, C504, C505, C604, C605, C704, C705, C804, C805: 220p C0G; C_0603_1608Metric; MPN Murata GRM1885C1H221GA01D
C106, C206, C306, C406, C506, C606, C706, C806: 2.2n C0G; C_0603_1608Metric; MPN KEMET C0603C222G5GACTU
C107, C108, C207, C208, C307, C308, C407, C408, C507, C508, C607, C608, C707, C708, C807, C808: 100n; C_0603_1608Metric; MPN KEMET C0603C104K5RACTU
C109, C309, C509, C709: 1u; C_0603_1608Metric; MPN KEMET C0603C105K4RACTU
D101, D201, D301, D401, D501, D601, D701, D801: ESD2CAN24-Q1; SOT-23; MPN TI ESD2CAN24DBZRQ1
J1: DB25 female R/A; DSUB-25_Female_Horizontal_P2.77x2.84mm_EdgePinOffset9.90mm_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; MPN Amphenol L77SDB25S1ACH4F
J2: MC6 socket 2x20 2.00mm; PinSocket_2x20_P2.00mm_Vertical; MPN Harwin M22-7142042
J3: MC9 socket 1x20 2.00mm (GND); PinSocket_1x20_P2.00mm_Vertical; MPN Harwin M22-7132042
R1, R2: 2.2k; R_0603_1608Metric; MPN Yageo RC0603FR-072K2L
R3: 100k; R_0603_1608Metric; MPN Yageo RC0603FR-07100KL
R4, R5, R7, R8: 33R; R_0603_1608Metric; MPN Yageo RC0603FR-0733RL
R6: 0R (link); R_0603_1608Metric; MPN Yageo RC0603JR-070RL
R9: 18.2k 1%; R_0603_1608Metric; MPN Yageo RC0603FR-0718K2L
R10: 14.7k 1%; R_0603_1608Metric; MPN Yageo RC0603FR-0714K7L
R11: 100R; R_0603_1608Metric; MPN Yageo RC0603FR-07100RL
R12: 0R; R_0603_1608Metric; MPN Yageo RC0603JR-070RL
R13: 100R DNP; R_0603_1608Metric; not fitted
R101, R102, R201, R202, R301, R302, R401, R402, R501, R502, R601, R602, R701, R702, R801, R802: 20.0k 0.1%; R_0603_1608Metric; MPN Susumu RG1608P-203-B-T5
R103, R104, R203, R204, R303, R304, R403, R404, R503, R504, R603, R604, R703, R704, R803, R804: 4.02k 0.1%; R_0603_1608Metric; MPN Susumu RG1608P-4021-B-T5
R105, R106, R205, R206, R305, R306, R405, R406, R505, R506, R605, R606, R705, R706, R805, R806: 13.7k; R_0603_1608Metric; MPN Yageo RC0603FR-0713K7L
R107, R108, R207, R208, R307, R308, R407, R408, R507, R508, R607, R608, R707, R708, R807, R808: 47R; R_0603_1608Metric; MPN Yageo RC0603FR-0747RL
R109, R110, R209, R210, R309, R310, R409, R410, R509, R510, R609, R610, R709, R710, R809, R810: 0R; R_1206_3216Metric; MPN Yageo RC1206JR-070RL
U1, U2: TLV320ADC5140IRTWR; Texas_RTW_WQFN-24-1EP_4x4mm_P0.5mm_EP2.7x2.7mm_ThermalVias; MPN TI TLV320ADC5140IRTWR
U3: TLV9061IDBVR; SOT-23-5; MPN TI TLV9061IDBVR
U4, U5: THS4524IDBTR; TSSOP-38_4.4x9.7mm_P0.5mm; MPN TI THS4524IDBTR

Connections:
AREG_A: C3.1, C4.1, U1.2 (AREG)
AREG_B: C13.1, C14.1, U2.2 (AREG)
AVDD_ADC: C1.1, C2.1, C11.1, C12.1, R9.1, U1.1 (AVDD), U2.1 (AVDD)
AVDD_FE: C22.1, C108.1, C109.1, C208.1, C308.1, C309.1, C408.1, C508.1, C509.1, C608.1, C708.1, C709.1, C808.1, U3.5 (V+), U4.1 (PD1), U4.6 (PD2), U4.11 (PD3), U4.16 (PD4), U4.20 (VS4+), U4.25 (VS3+), U4.30 (VS2+), U4.35 (VS1+), U5.1 (PD1), U5.6 (PD2), U5.11 (PD3), U5.16 (PD4), U5.20 (VS4+), U5.25 (VS3+), U5.30 (VS2+), U5.35 (VS1+)
BCLK: R7.2, U1.22 (BCLK), U2.22 (BCLK)
BCLK_FPGA: J2.18, R7.1
CH1_M: R110.2, U1.7 (IN1M_GPO1)
CH1_P: R109.2, U1.6 (IN1P_GPI1)
CH2_M: R210.2, U1.9 (IN2M_GPO2)
CH2_P: R209.2, U1.8 (IN2P_GPI2)
CH3_M: R310.2, U1.11 (IN3M_GPO3)
CH3_P: R309.2, U1.10 (IN3P_GPI3)
CH4_M: R410.2, U1.13 (IN4M_GPO4)
CH4_P: R409.2, U1.12 (IN4P_GPI4)
CH5_M: R510.2, U2.7 (IN1M_GPO1)
CH5_P: R509.2, U2.6 (IN1P_GPI1)
CH6_M: R610.2, U2.9 (IN2M_GPO2)
CH6_P: R609.2, U2.8 (IN2P_GPI2)
CH7_M: R710.2, U2.11 (IN3M_GPO3)
CH7_P: R709.2, U2.10 (IN3P_GPI3)
CH8_M: R810.2, U2.13 (IN4M_GPO4)
CH8_P: R809.2, U2.12 (IN4P_GPI4)
DB25_SHELL: C23.1, J1.0 (PAD), R12.1, R13.1
DREG_A: C9.1, C10.1, U1.24 (DREG)
DREG_B: C19.1, C20.1, U2.24 (DREG)
FE1_AM: C103.2, R102.2, R104.1, R106.1
FE1_AP: C103.1, R101.2, R103.1, R105.1
FE1_INM: C105.1, R106.2, U4.3 (VIN1-)
FE1_INP: C104.1, R105.2, U4.2 (VIN1+)
FE1_OUTM: C104.2, R103.2, R108.1, U4.37 (VOUT1-)
FE1_OUTP: C105.2, R104.2, R107.1, U4.36 (VOUT1+)
FE1_RM: C106.2, R108.2, R110.1
FE1_RP: C106.1, R107.2, R109.1
FE2_AM: C203.2, R202.2, R204.1, R206.1
FE2_AP: C203.1, R201.2, R203.1, R205.1
FE2_INM: C205.1, R206.2, U4.8 (VIN2-)
FE2_INP: C204.1, R205.2, U4.7 (VIN2+)
FE2_OUTM: C204.2, R203.2, R208.1, U4.32 (VOUT2-)
FE2_OUTP: C205.2, R204.2, R207.1, U4.31 (VOUT2+)
FE2_RM: C206.2, R208.2, R210.1
FE2_RP: C206.1, R207.2, R209.1
FE3_AM: C303.2, R302.2, R304.1, R306.1
FE3_AP: C303.1, R301.2, R303.1, R305.1
FE3_INM: C305.1, R306.2, U4.13 (VIN3-)
FE3_INP: C304.1, R305.2, U4.12 (VIN3+)
FE3_OUTM: C304.2, R303.2, R308.1, U4.27 (VOUT3-)
FE3_OUTP: C305.2, R304.2, R307.1, U4.26 (VOUT3+)
FE3_RM: C306.2, R308.2, R310.1
FE3_RP: C306.1, R307.2, R309.1
FE4_AM: C403.2, R402.2, R404.1, R406.1
FE4_AP: C403.1, R401.2, R403.1, R405.1
FE4_INM: C405.1, R406.2, U4.18 (VIN4-)
FE4_INP: C404.1, R405.2, U4.17 (VIN4+)
FE4_OUTM: C404.2, R403.2, R408.1, U4.22 (VOUT4-)
FE4_OUTP: C405.2, R404.2, R407.1, U4.21 (VOUT4+)
FE4_RM: C406.2, R408.2, R410.1
FE4_RP: C406.1, R407.2, R409.1
FE5_AM: C503.2, R502.2, R504.1, R506.1
FE5_AP: C503.1, R501.2, R503.1, R505.1
FE5_INM: C505.1, R506.2, U5.3 (VIN1-)
FE5_INP: C504.1, R505.2, U5.2 (VIN1+)
FE5_OUTM: C504.2, R503.2, R508.1, U5.37 (VOUT1-)
FE5_OUTP: C505.2, R504.2, R507.1, U5.36 (VOUT1+)
FE5_RM: C506.2, R508.2, R510.1
FE5_RP: C506.1, R507.2, R509.1
FE6_AM: C603.2, R602.2, R604.1, R606.1
FE6_AP: C603.1, R601.2, R603.1, R605.1
FE6_INM: C605.1, R606.2, U5.8 (VIN2-)
FE6_INP: C604.1, R605.2, U5.7 (VIN2+)
FE6_OUTM: C604.2, R603.2, R608.1, U5.32 (VOUT2-)
FE6_OUTP: C605.2, R604.2, R607.1, U5.31 (VOUT2+)
FE6_RM: C606.2, R608.2, R610.1
FE6_RP: C606.1, R607.2, R609.1
FE7_AM: C703.2, R702.2, R704.1, R706.1
FE7_AP: C703.1, R701.2, R703.1, R705.1
FE7_INM: C705.1, R706.2, U5.13 (VIN3-)
FE7_INP: C704.1, R705.2, U5.12 (VIN3+)
FE7_OUTM: C704.2, R703.2, R708.1, U5.27 (VOUT3-)
FE7_OUTP: C705.2, R704.2, R707.1, U5.26 (VOUT3+)
FE7_RM: C706.2, R708.2, R710.1
FE7_RP: C706.1, R707.2, R709.1
FE8_AM: C803.2, R802.2, R804.1, R806.1
FE8_AP: C803.1, R801.2, R803.1, R805.1
FE8_INM: C805.1, R806.2, U5.18 (VIN4-)
FE8_INP: C804.1, R805.2, U5.17 (VIN4+)
FE8_OUTM: C804.2, R803.2, R808.1, U5.22 (VOUT4-)
FE8_OUTP: C805.2, R804.2, R807.1, U5.21 (VOUT4+)
FE8_RM: C806.2, R808.2, R810.1
FE8_RP: C806.1, R807.2, R809.1
FSYNC: R8.2, U1.23 (FSYNC), U2.23 (FSYNC)
FSYNC_FPGA: J2.22, R8.1
GND: C1.2, C2.2, C3.2, C4.2, C5.2, C6.2, C7.2, C8.2, C9.2, C10.2, C11.2, C12.2, C13.2, C14.2, C15.2, C16.2, C17.2, C18.2, C19.2, C20.2, C21.2, C22.2, C23.2, C101.2, C102.2, C107.2, C108.2, C109.2, C201.2, C202.2, C207.2, C208.2, C301.2, C302.2, C307.2, C308.2, C309.2, C401.2, C402.2, C407.2, C408.2, C501.2, C502.2, C507.2, C508.2, C509.2, C601.2, C602.2, C607.2, C608.2, C701.2, C702.2, C707.2, C708.2, C709.2, C801.2, C802.2, C807.2, C808.2, D101.3 (GND), D201.3 (GND), D301.3 (GND), D401.3 (GND), D501.3 (GND), D601.3 (GND), D701.3 (GND), D801.3 (GND), J1.2, J1.5, J1.8, J1.11, J1.16, J1.19, J1.22, J1.25, J3.1, J3.2, J3.3, J3.4, J3.5, J3.6, J3.7, J3.8, J3.9, J3.10, J3.11, J3.12, J3.13, J3.14, J3.15, J3.16, J3.17, J3.18, J3.19, J3.20, R3.2, R10.2, R12.2, R13.2, U1.4 (AVSS), U1.15 (ADDR1_MISO), U1.16 (ADDR0_SCLK), U1.25 (VSS(EP)), U2.4 (AVSS), U2.15 (ADDR1_MISO), U2.25 (VSS(EP)), U3.2 (V-), U4.5 (VS-), U4.10 (VS-), U4.15 (VS-), U4.23 (VS-), U4.24 (VS-), U4.28 (VS-), U4.29 (VS-), U4.33 (VS-), U4.34 (VS-), U4.38 (VS-), U5.5 (VS-), U5.10 (VS-), U5.15 (VS-), U5.23 (VS-), U5.24 (VS-), U5.28 (VS-), U5.29 (VS-), U5.33 (VS-), U5.34 (VS-), U5.38 (VS-)
I2C_SCL: J2.14, R1.2, U1.17 (SCL_MOSI), U2.17 (SCL_MOSI)
I2C_SDA: J2.10, R2.2, U1.18 (SDA_SSZ), U2.18 (SDA_SSZ)
IN1_COLD: C102.1, D101.2 (IO2), J1.12, R102.1
IN1_HOT: C101.1, D101.1 (IO1), J1.24, R101.1
IN2_COLD: C202.1, D201.2 (IO2), J1.23, R202.1
IN2_HOT: C201.1, D201.1 (IO1), J1.10, R201.1
IN3_COLD: C302.1, D301.2 (IO2), J1.9, R302.1
IN3_HOT: C301.1, D301.1 (IO1), J1.21, R301.1
IN4_COLD: C402.1, D401.2 (IO2), J1.20, R402.1
IN4_HOT: C401.1, D401.1 (IO1), J1.7, R401.1
IN5_COLD: C502.1, D501.2 (IO2), J1.6, R502.1
IN5_HOT: C501.1, D501.1 (IO1), J1.18, R501.1
IN6_COLD: C602.1, D601.2 (IO2), J1.17, R602.1
IN6_HOT: C601.1, D601.1 (IO1), J1.4, R601.1
IN7_COLD: C702.1, D701.2 (IO2), J1.3, R702.1
IN7_HOT: C701.1, D701.1 (IO1), J1.15, R701.1
IN8_COLD: C802.1, D801.2 (IO2), J1.14, R802.1
IN8_HOT: C801.1, D801.1 (IO1), J1.1, R801.1
IOVDD: C7.1, C8.1, C17.1, C18.1, R1.1, R2.1, U1.19 (IOVDD), U2.16 (ADDR0_SCLK), U2.19 (IOVDD)
IRQ_A_N: J2.5, U1.20 (GPIO1)
IRQ_B_N: J2.9, U2.20 (GPIO1)
MICBIAS_A: C6.1, U1.5 (MICBIAS)
MICBIAS_B: C16.1, U2.5 (MICBIAS)
PWR_GOOD: J2.13
SDOUT: J2.26, R4.2, R6.2
SDOUT_B: J2.30, R5.2, R6.1
SDOUT_RAW_A: R4.1, U1.21 (SDOUT)
SDOUT_RAW_B: R5.1, U2.21 (SDOUT)
SHDNZ: J2.1, R3.1, U1.14 (SHDNZ), U2.14 (SHDNZ)
VOCM: C107.1, C207.1, C307.1, C407.1, C507.1, C607.1, C707.1, C807.1, R11.2, U4.4 (VOCM1), U4.9 (VOCM2), U4.14 (VOCM3), U4.19 (VOCM4), U5.4 (VOCM1), U5.9 (VOCM2), U5.14 (VOCM3), U5.19 (VOCM4)
VOCM_BUF: R11.1, U3.1, U3.4 (-)
VOCM_DIV: C21.1, R9.2, R10.1, U3.3 (+)
VREF_A: C5.1, U1.3 (VREF)
VREF_B: C15.1, U2.3 (VREF)

Notes on the sheet:
ADC SHEET - EOH lung array ADC board (owner: Tommy). 2x TLV320ADC5140 + 2x THS4524 (quad) front end + DB25 input + BRK8305 MC6/MC9 plug
Generated from gen_adc_sch.py (netlabel style). Pins connect by the label at the end of each stub. Rails (AVDD_ADC, AVDD_FE, IOVDD), PWR_GOOD and test points come from Vimal's power sheet.
Source of values: project-map/adc-board-circuit.md (front end, decoupling), fpga-interface.md (I2C addresses, TDM, pins). Tables: kicad/adc-sheet-tables.md
INPUT J1: DB25 female, TASCAM pinout
UMC1820 8 TRS line outs -> DB25-to-8xTRS snake
Shell ground-lift: R12 fitted 0R; if hum, remove R12 and fit R13+C23
CH1 front end: THS4524 diff MFB low-pass, gain 0.2 (-14 dB), 50 kHz Butterworth, DC-coupled to ADC A (U1) IN1
R109/R110 = Cc position (1206): 0R = DC-coupled (default). AC fallback: fit 22uF and set CHx_CFG0 = 0x84
Amplifier: U4 section 1 (VIN1+/- , VOUT1+/-), on the quad THS4524 below
CH2 front end: THS4524 diff MFB low-pass, gain 0.2 (-14 dB), 50 kHz Butterworth, DC-coupled to ADC A (U1) IN2
R209/R210 = Cc position (1206): 0R = DC-coupled (default). AC fallback: fit 22uF and set CHx_CFG0 = 0x84
Amplifier: U4 section 2 (VIN2+/- , VOUT2+/-), on the quad THS4524 below
CH3 front end: THS4524 diff MFB low-pass, gain 0.2 (-14 dB), 50 kHz Butterworth, DC-coupled to ADC A (U1) IN3
R309/R310 = Cc position (1206): 0R = DC-coupled (default). AC fallback: fit 22uF and set CHx_CFG0 = 0x84
Amplifier: U4 section 3 (VIN3+/- , VOUT3+/-), on the quad THS4524 below
CH4 front end: THS4524 diff MFB low-pass, gain 0.2 (-14 dB), 50 kHz Butterworth, DC-coupled to ADC A (U1) IN4
R409/R410 = Cc position (1206): 0R = DC-coupled (default). AC fallback: fit 22uF and set CHx_CFG0 = 0x84
Amplifier: U4 section 4 (VIN4+/- , VOUT4+/-), on the quad THS4524 below
CH5 front end: THS4524 diff MFB low-pass, gain 0.2 (-14 dB), 50 kHz Butterworth, DC-coupled to ADC B (U2) IN1
R509/R510 = Cc position (1206): 0R = DC-coupled (default). AC fallback: fit 22uF and set CHx_CFG0 = 0x84
Amplifier: U5 section 1 (VIN1+/- , VOUT1+/-), on the quad THS4524 below
CH6 front end: THS4524 diff MFB low-pass, gain 0.2 (-14 dB), 50 kHz Butterworth, DC-coupled to ADC B (U2) IN2
R609/R610 = Cc position (1206): 0R = DC-coupled (default). AC fallback: fit 22uF and set CHx_CFG0 = 0x84
Amplifier: U5 section 2 (VIN2+/- , VOUT2+/-), on the quad THS4524 below
CH7 front end: THS4524 diff MFB low-pass, gain 0.2 (-14 dB), 50 kHz Butterworth, DC-coupled to ADC B (U2) IN3
R709/R710 = Cc position (1206): 0R = DC-coupled (default). AC fallback: fit 22uF and set CHx_CFG0 = 0x84
Amplifier: U5 section 3 (VIN3+/- , VOUT3+/-), on the quad THS4524 below
CH8 front end: THS4524 diff MFB low-pass, gain 0.2 (-14 dB), 50 kHz Butterworth, DC-coupled to ADC B (U2) IN4
R809/R810 = Cc position (1206): 0R = DC-coupled (default). AC fallback: fit 22uF and set CHx_CFG0 = 0x84
Amplifier: U5 section 4 (VIN4+/- , VOUT4+/-), on the quad THS4524 below
FRONT-END AMPLIFIERS: 2x THS4524 quad fully differential amp (U4 = CH1-4, U5 = CH5-8). Same amplifier as THS4521, four per package.
Every PD pin tied to AVDD_FE (always on). All VS- pins to GND. Each VSn+ pin has its own 100n (C_08 of that channel), each VOCMn pin its own 100n (C_07).
VOCM: 1.474 V from AVDD_ADC divider, buffered by TLV9061 (matches ADC5140 internal input bias ~1.48 V). DNP R11 to let each THS4524 VOCM float to 1.65 V
ADC A: TLV320ADC5140 (U1), I2C 0x4C, channels 1-4 -> TDM slots 0-3
U1 decoupling: each cap right at its pin.
VREF/MICBIAS cap grounds go straight to AVSS pin 4, no via.
Confirm values vs datasheet Fig. 172 / EVM schematic.
ADC B: TLV320ADC5140 (U2), I2C 0x4D, channels 5-8 -> TDM slots 4-7
U2 decoupling: each cap right at its pin.
DIGITAL GLUE: I2C pull-ups, SHDNZ pull-down, 33R series, SDOUT_B link
R6 fitted: both ADCs share SDOUT (TI scheme). R6 removed: ADC B uses its own lane SDOUT_B (MC6-30).
R4/R5 sit at each ADC's SDOUT pin; R7/R8 sit at the MC6 socket.
FPGA PLUG J2/J3: 2x20 2.00 mm socket onto BRK8305 MC6
MC6 = banks 85/86 at 1.8 V, no ground pins. J3 1x20 socket onto MC9 = all GND (ground return).
All signals on bank 86. Unused MC6 pins are left open (they are FPGA I/O: never tie them to GND).
Check on the real BRK8305 which MC6 row (odd or even) is nearer MC9; the clock pins (BCLK 18, FSYNC 22, SDOUT 26) are on the even row.
MC6-1 = B86_L9N
MC6-3 = B86_L9P
MC6-5 = B86_L10N
MC6-7 = B86_L10P
MC6-9 = B86_L11N
MC6-11 = B86_L11P
MC6-13 = B86_L12N
MC6-15 = B86_L12P
MC6-17 = B85_L12N
MC6-19 = B85_L12P
MC6-21 = B85_L11N
MC6-23 = B85_L11P
MC6-25 = B85_L10N
MC6-27 = B85_L10P
MC6-29 = B85_L9N
MC6-31 = B85_L9P
MC6-33 = B85_L8N_HDGC
MC6-35 = B85_L8P_HDGC
MC6-37 = B85_L7N_HDGC
MC6-39 = B85_L7P_HDGC
MC6-2 = NC
MC6-4 = NC
MC6-6 = NC
MC6-8 = B86_L1N
MC6-10 = B86_L1P
MC6-12 = B86_L2N
MC6-14 = B86_L2P
MC6-16 = B86_L7N_HDGC
MC6-18 = B86_L7P_HDGC
MC6-20 = B86_L8N_HDGC
MC6-22 = B86_L8P_HDGC
MC6-24 = B86_L3N
MC6-26 = B86_L3P
MC6-28 = B86_L4N
MC6-30 = B86_L4P
MC6-32 = B86_L5N_HDGC
MC6-34 = B86_L5P_HDGC
MC6-36 = B86_L6N_HDGC
MC6-38 = B86_L6P_HDGC
MC6-40 = B85_L6N_HDGC
