sbiruduganti/IEEE-EOH-Acoustic-Array-Lung-Monitor/(commit log)

2026-10-15 Initial commit: 8-channel acoustic array prototype and Streamlit UI
2026-10-22 Fix device placement for Brevitas quantization buffers
2026-10-28 Circuit Design branch
2026-10-28 Revert "Circuit Design branch"
    This reverts commit 9526fcbd148a32a169e3ad6c6d50a7fcc3961f2a.
2026-10-28 Add circuit-design folder with KiCAD files
2026-10-28 Reset circuit-design folder to a basic README
2026-10-28 Add KiCAD folder, BOM and design choices files, expand README
2026-10-29 attempting cosineannealinglr and 0.75 power inverse class weighting
2026-11-07 Added half of power circuitry to schematic
2026-11-07 FPGA Connectors (J10 -> MC6, J11 -> MC9 GND)
2026-11-07 Add IEEE Project_withconnector schematic
2026-11-07 Added Connectors to main
2026-11-08 Added power and connectivity
2026-11-08 Fix ADC wiring: labels, AVDD, EP, DREG, addresses, amp grounds
2026-11-12 Clean up KiCad folder: move project into KiCAD/, remove junk and old copies
2026-11-12 Add buffer, series resistors and SDOUT_B to FPGA connector
2026-11-12 Tidy main schematic layout
